whoisLePhuc/robot_charge_controller/simulation/README.md

# Simulation

This directory is reserved for SPICE testbenches, component models, simulation parameters, and analyzed results.

Every simulation must record model source and version, schematic revision, boundary conditions, sweeps or corners, limitations, and measurable acceptance criteria.
