whoisLePhuc/robot_charge_controller/tools/README.md

# Tools

Repository validation, export, and automation utilities belong here.

## Available Tool

- check_repository.py validates the baseline directory structure, Markdown encoding, documented path case, and local Markdown links.

KiCad source modifications must not be implemented with general-purpose text scripts; use the approved Konnect workflow.
