whoisLePhuc/robot_charge_controller/docs/03-design/README.md

# Detailed Design

This directory contains detailed circuit, component-selection, PCB-layout, and embedded-design documentation.

## Contents

- [`guides/`](guides/README.md): project layout, routing, EMI, and netclass guidance imported from the engineering workspace.

Guides provide design rationale and constraints; they do not replace schematic/PCB review, calculations, simulation, or verification evidence for a particular revision.
