whoisLePhuc/robot_charge_controller/hardware/templates/README.md

# Hardware Templates

Reusable, reviewed KiCad templates may be stored here.

The directory is currently a scaffold. A template must document its intended use, assumptions, library dependencies, KiCad version, and verification status.
