whoisLePhuc/robot_charge_controller/docs/04-calculations/README.md

# Calculations

This directory contains auditable engineering calculations associated with specific hardware revisions.

## Current Artifact

- [`INA241A2IDDFR_Output_Calculation.pdf`](INA241A2IDDFR_Output_Calculation.pdf): imported from the workspace calculation directory without transformation on 2026-08-25.

The imported PDF is supporting evidence only. Its input values, component identity, tolerances, temperature assumptions, schematic revision, and acceptance criteria must be reviewed before its results are used for a design or release decision.
