whoisLePhuc/robot_charge_controller/docs/05-reviews/README.md

# Reviews

This directory contains schematic, PCB, safety, EMC, thermal, reliability, manufacturability, and integration review findings.

Each review must identify the exact artifact revision, scope, tool versions, evidence, severity, disposition, owner, and open verification action. Review completion is not release authorization.
