whoisLePhuc/robot_charge_controller/firmware/src/README.md

# Firmware Source

Application entry points, state machines, hardware integration, and orchestration code belong here.

The source tree is currently a scaffold. Relay control must default to a defined safe state and must not be implemented before hardware and system requirements are recorded.
