whoisLePhuc/robot_charge_controller/docs/04-calculations/INA241A2IDDFR_Output_Calculation.pdf

## Tính toán tín hiệu đầu ra INA241A2IDDFR

## 1. Thông số thiết kế

Thông số | Ký hiệu | Giá trị
IC đo dòng | — | INA241A2IDDFR
Hệ số khuếch đại | G | 20 V /V
Điện trở shunt R17 | RS | 1, 8 mΩ
Nguồn cấp INA241 | VS | 3, 3 V
Điện áp tại REF1 | VREF1 | 3, 3 V
Điện áp tại REF2 | VREF2 | 0 V
Độ phân giải ADC giả định | — | 12 bit
Giá trị ADC lớn nhất | ADCFS | 4095

## 2. Điện áp tham chiếu đầu ra

Điện áp tham chiếu tương đương tại đầu ra được tính bằng:

VREF =

VREF1 + VREF2

2

Thay số:

VREF =

3, 3 + 0

2

= 1, 65 V

Do đó, khi dòng qua R17 bằng 0 A:

## 3. Điện áp vi sai trên điện trở shunt

Điện áp trên R17 được tính theo định luật Ohm:

VSHUNT = VIN+ − VIN− = I × RS

Với:

RS = 1, 8 mΩ = 0, 0018 Ω

VOUT (0 A) = 1, 65 V

Suy ra:

VSHUNT = 0, 0018I

Trong đó I được tính bằng ampere và VSHUNT được tính bằng volt.

Ví dụ tại dòng 20 A:

VSHUNT = 20 × 0, 0018 = 0, 036 V = 36 mV

## 4. Công thức điện áp đầu ra INA241A2

Điện áp đầu ra lý tưởng của INA241 được xác định bởi:

VOUT = VREF + G(VIN+ − VIN−)

Thay VIN+ − VIN− = I × RS:

VOUT = VREF + G × I × RS

Thay các giá trị của thiết kế:

VOUT = 1, 65 + 20 × I × 0, 0018

Suy ra công thức rút gọn:

Trong đó:

## 5. Quy ước chiều dòng điện

Nếu kết nối:

Thì:

Trạng thái | Quan hệ đầu ra
Dòng từ nguồn sang tải | VOUT > 1, 65 V
Không có dòng | VOUT ≈ 1, 65 V
Dòng từ tải về nguồn | VOUT < 1, 65 V

VOUT = 1, 65 + 0, 036I

I tính bằng ampere.
VOUT tính bằng volt.
Độ nhạy của mạch đo là 36 mV /A.

IN+ ở phía nguồn.
IN− ở phía tải.

Nếu đảo IN+ và IN− , dấu của thành phần dòng trong công thức cũng bị đảo.

## 6. Bảng điện áp đầu ra theo dòng điện

Dòng I | Điện áp trên R17 VSHUNT | Thành phần khuếch đại G × VSHUNT | Điện áp đầu ra VOUT
−31, 4 A | −56, 52 mV | −1, 1304 V | 0, 5196 V
−27, 8 A | −50, 04 mV | −1, 0008 V | 0, 6492 V
−20 A | −36 mV | −0, 72 V | 0, 93 V
−10 A | −18 mV | −0, 36 V | 1, 29 V
0 A | 0 mV | 0 V | 1, 65 V
+10 A | +18 mV | +0, 36 V | 2, 01 V
+20 A | +36 mV | +0, 72 V | 2, 37 V
+27, 8 A | +50, 04 mV | +1, 0008 V | 2, 6508 V
+31, 4 A | +56, 52 mV | +1, 1304 V | 2, 7804 V

Tại dòng hoạt động liên tục 20 A:

Tại ngưỡng giới hạn dòng danh định của LT4356, xấp xỉ 27,8 A:

Tại ngưỡng dòng cao nhất dự kiến, xấp xỉ 31,4 A:

Các giá trị này đều nhỏ hơn 3,3 V nên phù hợp với đầu vào ADC 3,3 V của ESP32 trong điều kiện thiết kế đang xét.

## 7. Tính dòng điện từ điện áp đầu ra

Từ công thức:

VOUT = 1, 65 + 0, 036I

Suy ra:

Ví dụ, khi ADC đo được VOUT = 2, 37 V :

I =

2, 37 − 1, 65

0, 036

= 20 A

VOUT (20 A) = 2, 37 V

VOUT (27, 8 A) ≈ 2, 651 V

VOUT (31, 4 A) ≈ 2, 780 V

I =

VOUT − 1, 65

0, 036

Khi ADC đo được VOUT = 0, 93 V :

I =

0, 93 − 1, 65

0, 036

= −20 A

## 8. Quy đổi sang ADC 12 bit

Với ADC 12 bit và điện áp toàn thang lý tưởng bằng 3,3 V:

ADC =

VOUT

3, 3

× 4095

Ngược lại:

VOUT =

ADC

4095

× 3, 3

Thay vào công thức tính dòng:

Có thể rút gọn thành:

Theo mô hình lý tưởng, độ phân giải dòng điện trên mỗi LSB là:

ΔILSB =

3, 3/4095

0, 036

≈ 0, 02238 A

## Bảng giá trị ADC lý tưởng

Dòng | VOUT | Giá trị ADC lý tưởng
−31, 4 A | 0, 520 V | khoảng 645
−27, 8 A | 0, 649 V | khoảng 805
−20 A | 0, 930 V | khoảng 1154
−10 A | 1, 290 V | khoảng 1600
0 A | 1, 650 V | khoảng 2048
+10 A | 2, 010 V | khoảng 2494
+20 A | 2, 370 V | khoảng 2941
+27, 8 A | 2, 651 V | khoảng 3289
+31, 4 A | 2, 780 V | khoảng 3450

I =

(
ADC

4095

× 3, 3) − 1, 65

0, 036

I ≈ 0, 02238(ADC − 2047, 5)

ΔILSB ≈ 22, 4 mA/LSB

Các giá trị ADC trong bảng là giá trị lý tưởng. ADC của ESP32 có sai số offset, sai số gain và độ phi tuyến; do đó cần hiệu chuẩn trên phần cứng thực tế.

## 9. Dải dòng tuyến tính gần đúng

Đầu ra INA241 không thể đạt hoàn toàn tới 0 V hoặc 3,3 V. Để ước lượng bảo thủ, giả sử vùng đầu ra sử dụng được là:

0, 02 V ≲ VOUT ≲ 3, 10 V

## Giới hạn dòng âm

IMIN =

0, 02 − 1, 65

0, 036

≈ −45, 3 A

## Giới hạn dòng dương

IMAX =

3, 10 − 1, 65

0, 036

≈ 40, 3 A

Suy ra dải dòng tuyến tính ước lượng:

Đây chỉ là ước lượng thiết kế. Giới hạn đầu ra chính xác phải được đối chiếu với điều kiện tải đầu ra, nguồn cấp, nhiệt độ và các thông số swing-to-rail trong datasheet.

Toàn bộ vùng dòng cần đo từ −20 A đến khoảng +31, 4 A vẫn nằm trong dải đầu ra dự kiến.

## 10. Sai số cần tính đến

Kết quả tính toán phía trên là giá trị lý tưởng. Sai số đo thực tế còn phụ thuộc vào:

Để giảm sai số:

−45, 3 A ≲ I ≲ +40, 3 A

Sai số và TCR của R17.
Điện áp offset đầu vào của INA241A2. Sai số hệ số khuếch đại của INA241A2.
Sai số điện áp tạo bởi REF1 và REF2 .
Nhiễu trên nguồn 3,3 V.
Sai số, độ phi tuyến và suy hao do mạch RC ở ADC ESP32. Điện trở đường mạch và chất lượng kết nối Kelvin tại R17. Nhiệt độ của shunt, INA241 và PCB.

Lấy IN+ và IN− trực tiếp từ hai điểm Kelvin của R17. Đặt tụ bypass 100 nF sát chân nguồn INA241.

## 11. Tài liệu tham khảo

Đặt bộ lọc RC giữa OUT và ADC, ví dụ 1 kΩ nối tiếp và 10 nF xuống GND.
Lấy nhiều mẫu ADC và lọc trung bình trong firmware.
Hiệu chuẩn zero-current sau khi hệ thống ổn định nhiệt.
Nếu có thể, dùng điện áp tham chiếu ADC đã hiệu chuẩn thay vì mặc định chính xác 3,3 V.

Texas Instruments — INA241A datasheet (https://www.ti.com/lit/ds/symlink/ina241a.pdf) Texas Instruments — INA241 product page (https://www.ti.com/product/INA241A)
