whoisLePhuc/robot_charge_controller/docs/README.md

# Documentation

Project documentation is organized by lifecycle stage:

| Directory | Purpose |
|---|---|
| [01-requirements/](01-requirements/README.md) | Controlled system and interface requirements |
| [02-architecture/](02-architecture/README.md) | Architecture options, boundaries, and trade-offs |
| [03-design/](03-design/README.md) | Detailed design records and implementation guides |
| [04-calculations/](04-calculations/README.md) | Auditable engineering calculations |
| [05-reviews/](05-reviews/README.md) | Review findings and dispositions |
| [06-verification/](06-verification/README.md) | Verification plans, results, and traceability |
| [decisions/](decisions/README.md) | Architecture decision records |
| [workflow.md](workflow.md) | Repository and development workflow |

Every consequential record should identify the applicable hardware variant and exact revision. Do not treat a generic guide or an unversioned workspace artifact as verification evidence for a release.
