whoisLePhuc/robot_charge_controller/hardware/Split_Board_Design/Consolidated/Control_board/00-two-layers.png

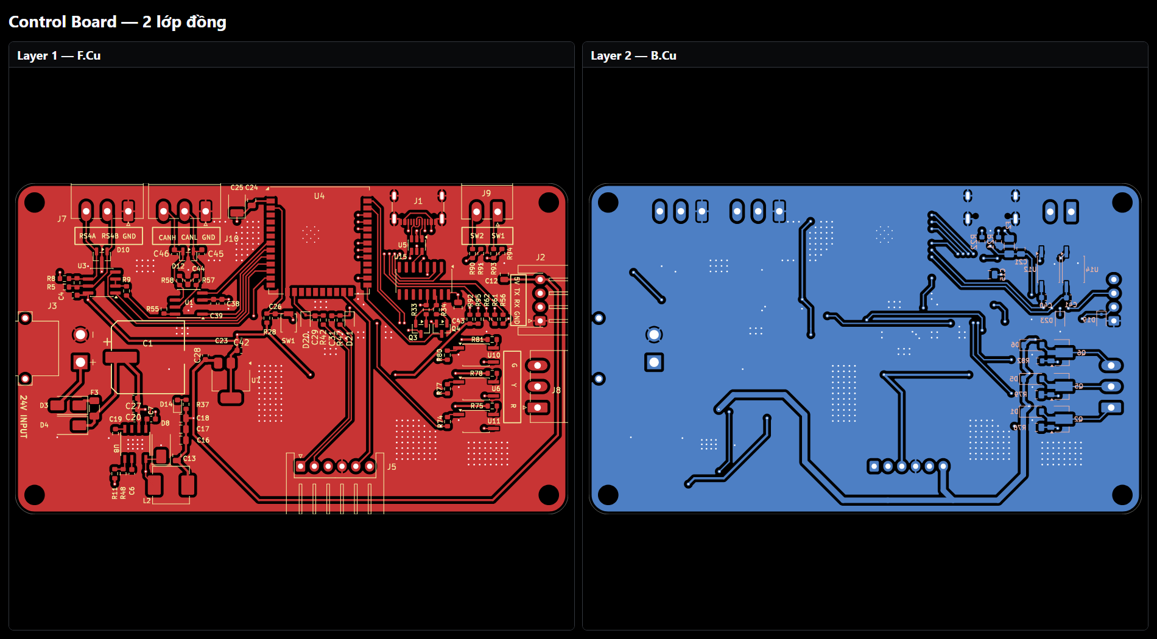
hardware/Split_Board_Design/Consolidated/Control_board/00-two-layers.png
