whoisLePhuc/robot_charge_controller/hardware/Split_Board_Design/Consolidated/Control_board/01-F_Cu.png

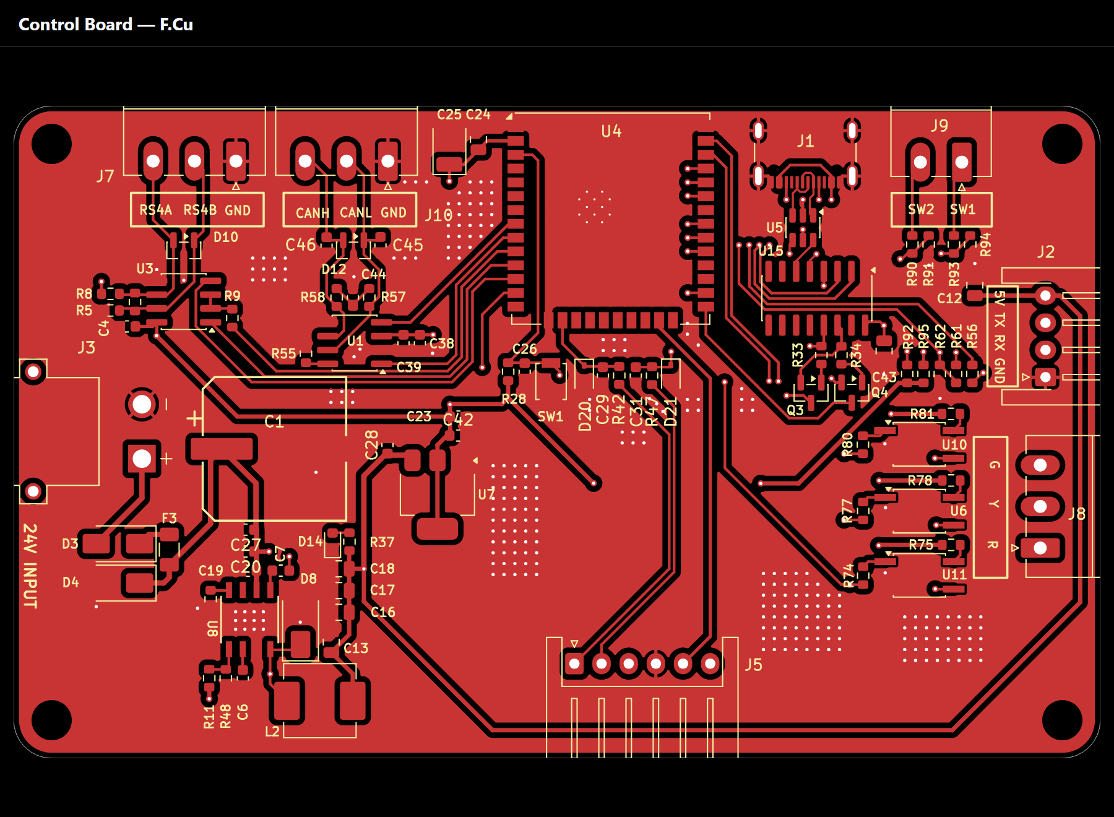
hardware/Split_Board_Design/Consolidated/Control_board/01-F_Cu.png
