whoisLePhuc/robot_charge_controller/hardware/Split_Board_Design/Consolidated/Control_board/02-B_Cu.png

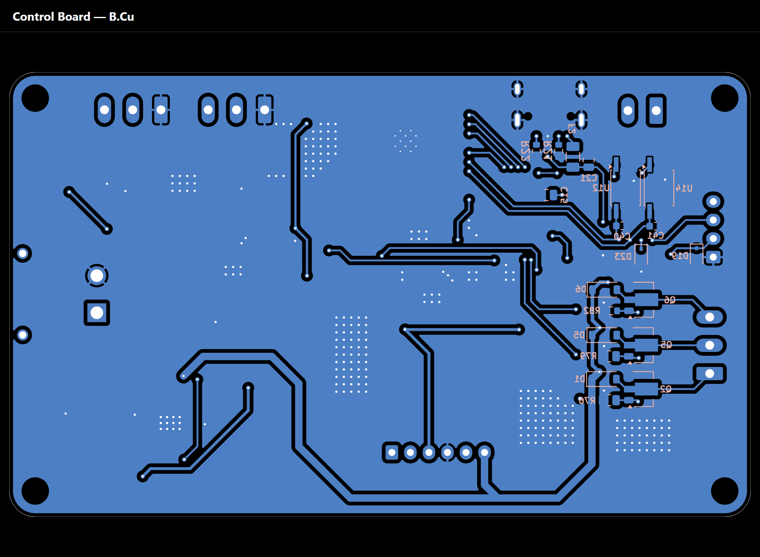
hardware/Split_Board_Design/Consolidated/Control_board/02-B_Cu.png
