whoisLePhuc/robot_charge_controller/hardware/Split_Board_Design/Consolidated/Control_board/03-3D-top.png

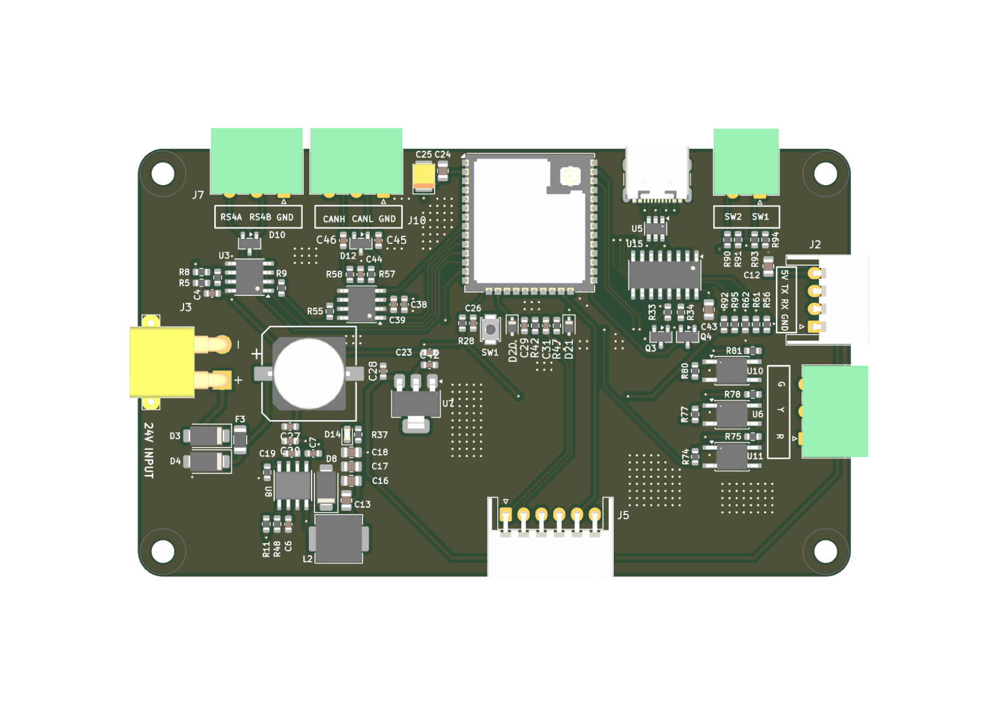
hardware/Split_Board_Design/Consolidated/Control_board/03-3D-top.png
