whoisLePhuc/robot_charge_controller/hardware/Split_Board_Design/Consolidated/Control_board/04-3D-bottom.png

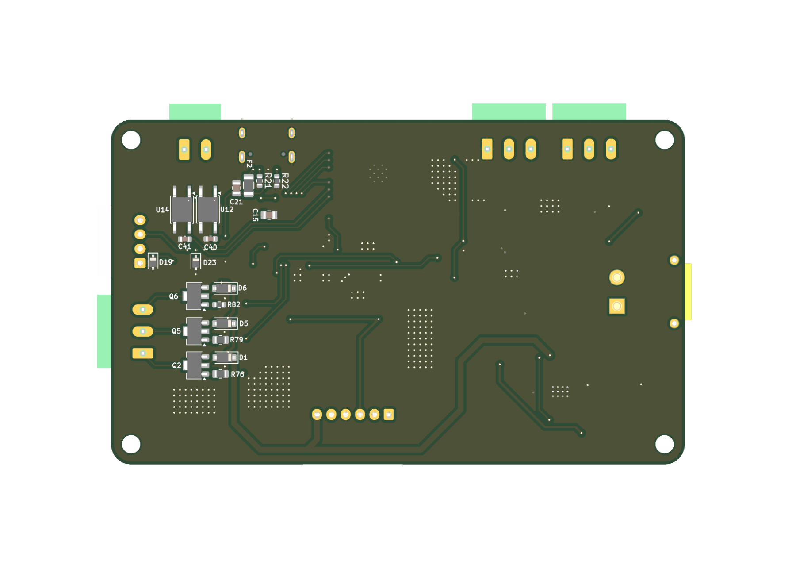
hardware/Split_Board_Design/Consolidated/Control_board/04-3D-bottom.png
