whoisLePhuc/robot_charge_controller/hardware/Split_Board_Design/Consolidated/Control_board/05-3D-isometric.png

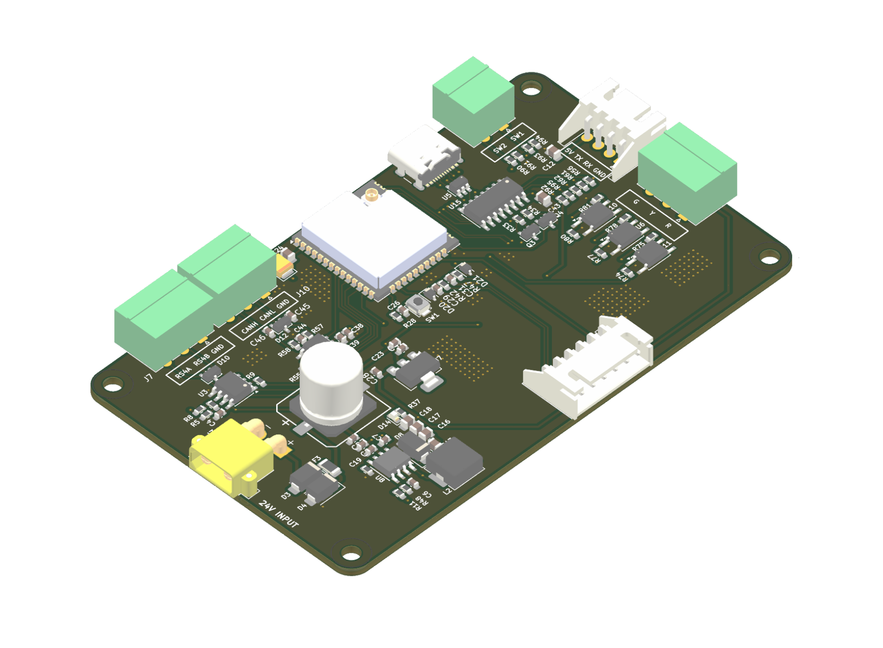
hardware/Split_Board_Design/Consolidated/Control_board/05-3D-isometric.png
