whoisLePhuc/robot_charge_controller/hardware/Split_Board_Design/Consolidated/Control_board/06-3D-isometric-opposite.png

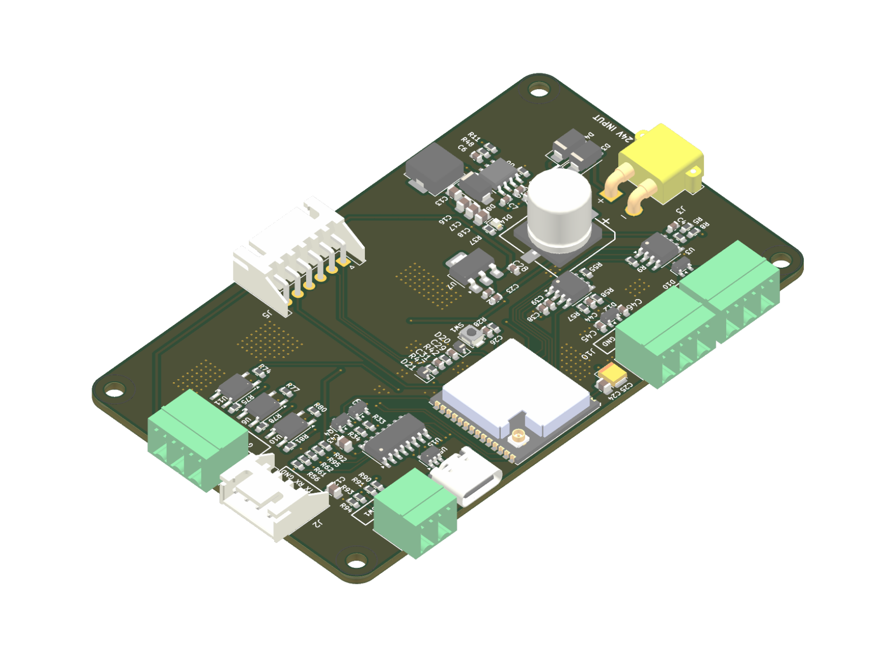
hardware/Split_Board_Design/Consolidated/Control_board/06-3D-isometric-opposite.png
