whoisLePhuc/robot_charge_controller/hardware/Split_Board_Design/Consolidated/Relay_board/00-four-layers.png

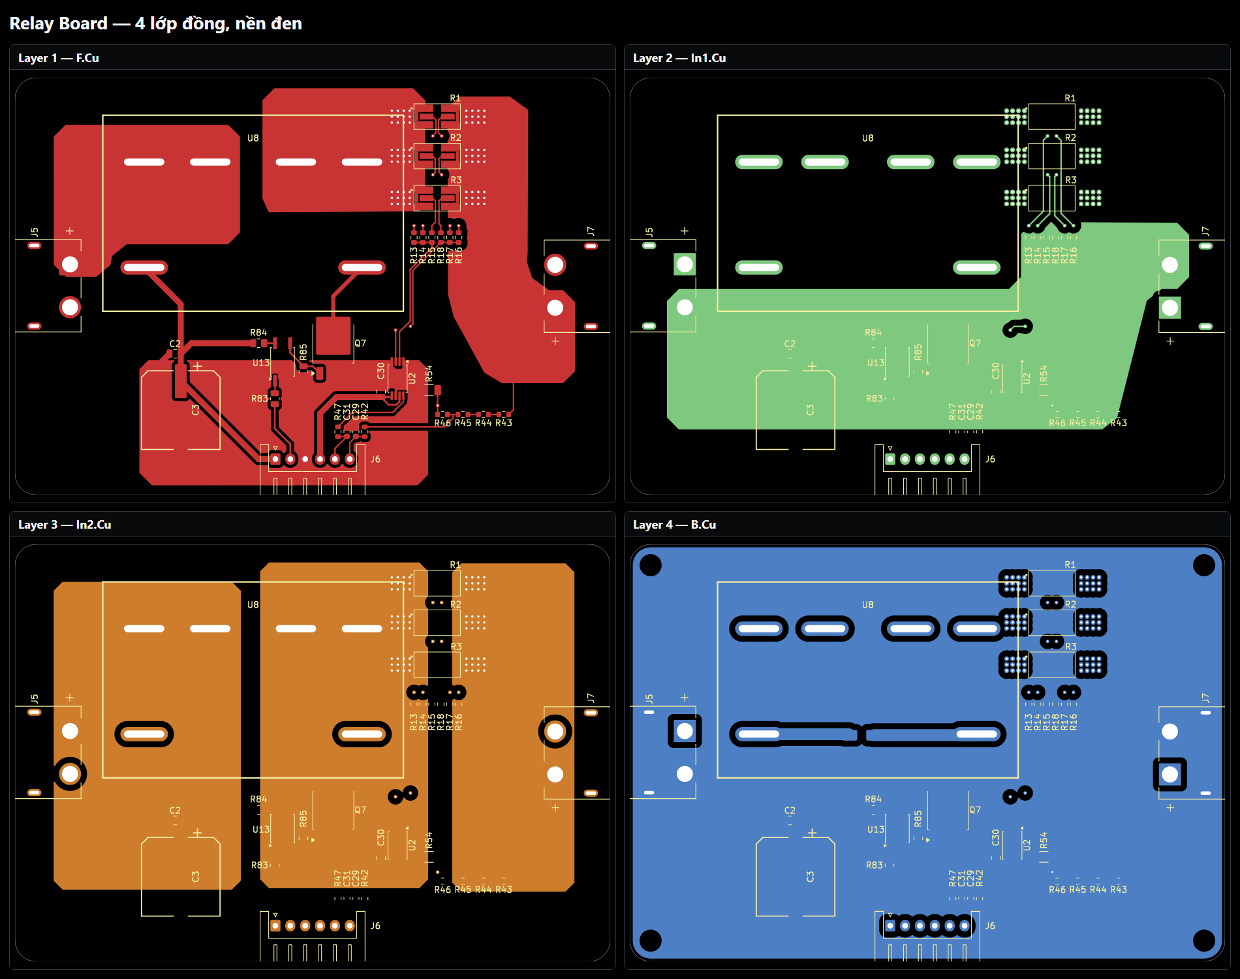
hardware/Split_Board_Design/Consolidated/Relay_board/00-four-layers.png
