whoisLePhuc/robot_charge_controller/hardware/Split_Board_Design/Consolidated/Relay_board/01-F_Cu.png

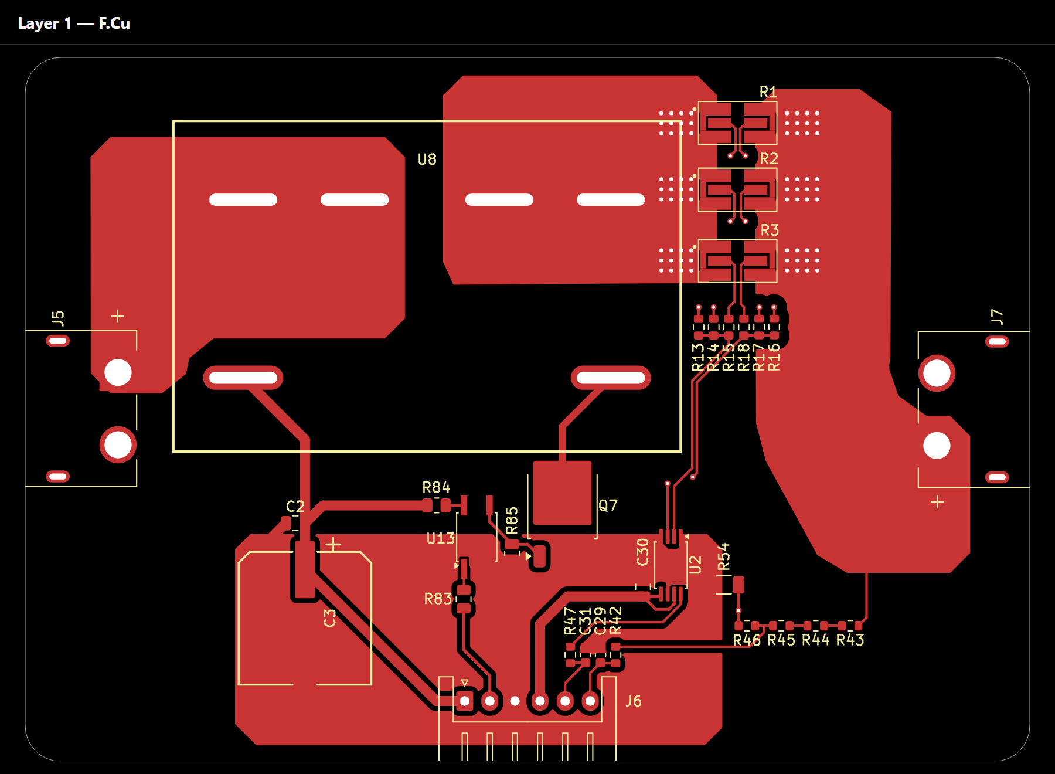
hardware/Split_Board_Design/Consolidated/Relay_board/01-F_Cu.png
