whoisLePhuc/robot_charge_controller/hardware/Split_Board_Design/Consolidated/Relay_board/02-In1_Cu.png

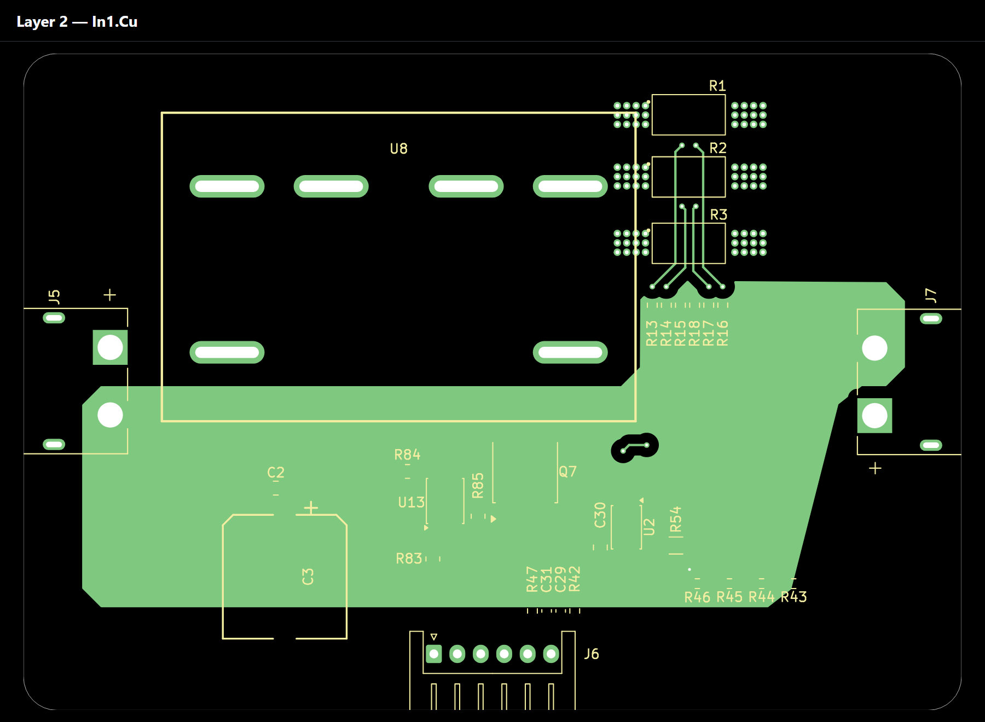
hardware/Split_Board_Design/Consolidated/Relay_board/02-In1_Cu.png
