whoisLePhuc/robot_charge_controller/hardware/Split_Board_Design/Consolidated/Relay_board/03-In2_Cu.png

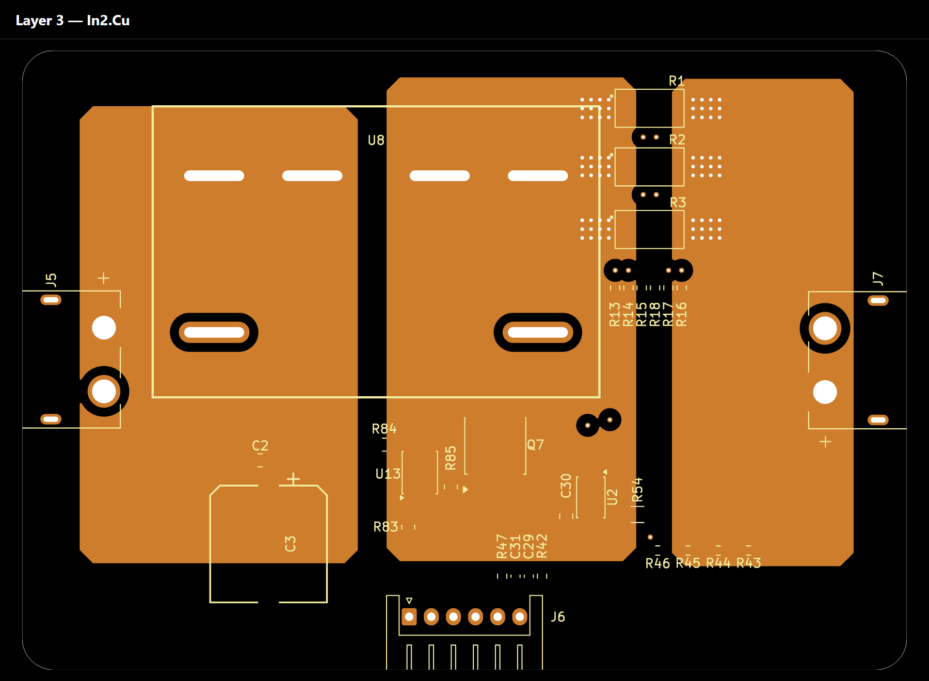
hardware/Split_Board_Design/Consolidated/Relay_board/03-In2_Cu.png
