whoisLePhuc/robot_charge_controller/hardware/Split_Board_Design/Consolidated/Relay_board/04-B_Cu.png

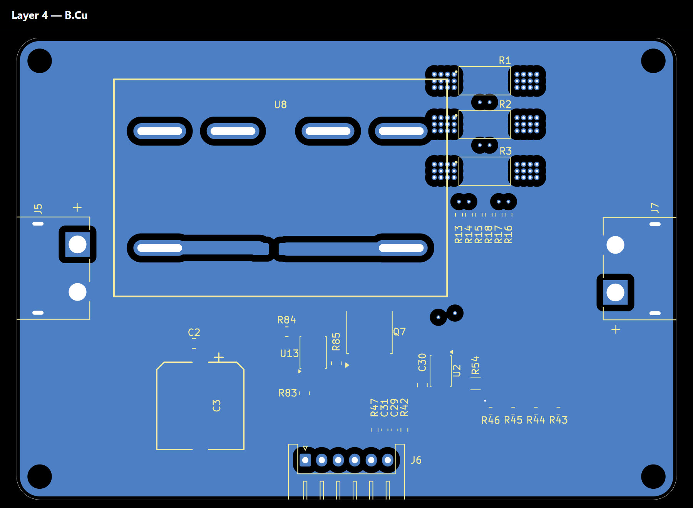
hardware/Split_Board_Design/Consolidated/Relay_board/04-B_Cu.png
