whoisLePhuc/robot_charge_controller/hardware/Split_Board_Design/Consolidated/Relay_board/05-3D-top.png

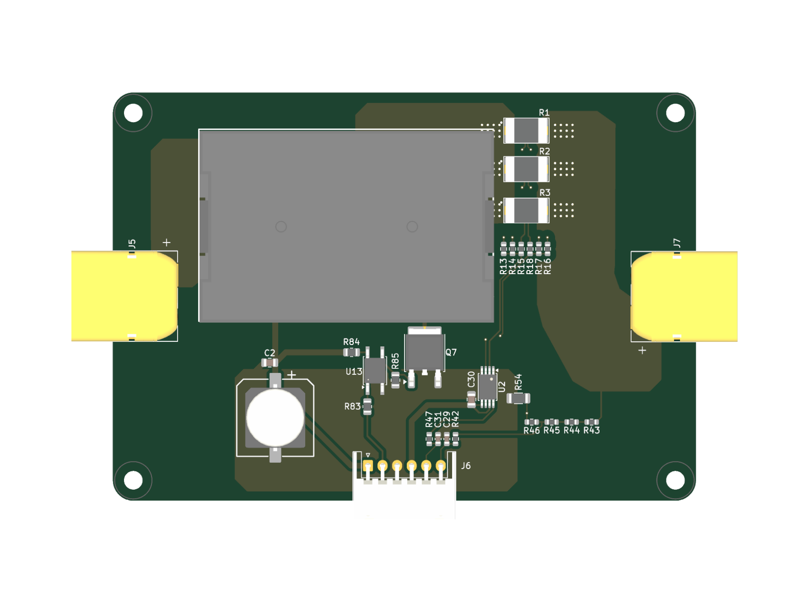
hardware/Split_Board_Design/Consolidated/Relay_board/05-3D-top.png
