whoisLePhuc/robot_charge_controller/hardware/Split_Board_Design/Consolidated/Relay_board/06-3D-bottom.png

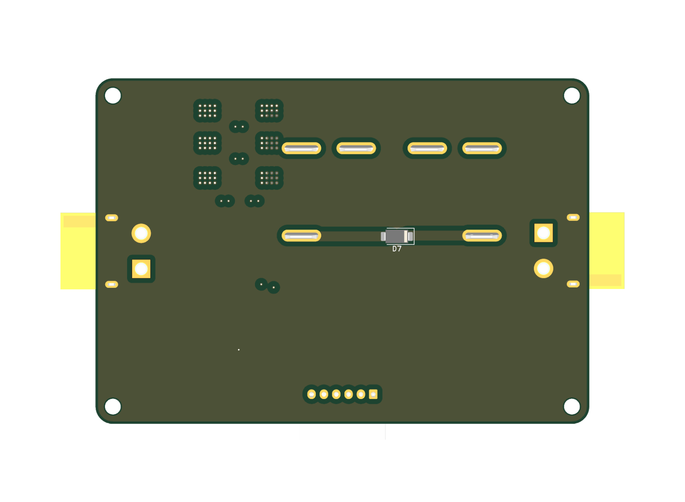
hardware/Split_Board_Design/Consolidated/Relay_board/06-3D-bottom.png
