whoisLePhuc/robot_charge_controller/hardware/Split_Board_Design/Consolidated/Relay_board/07-3D-isometric.png

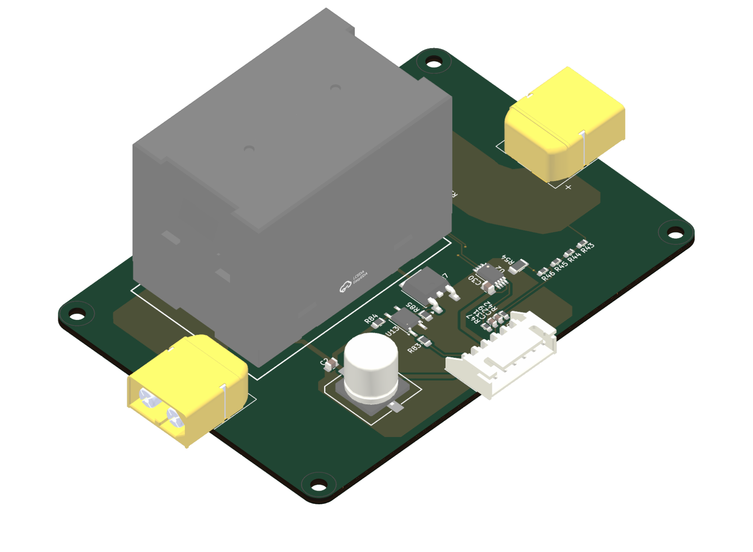
hardware/Split_Board_Design/Consolidated/Relay_board/07-3D-isometric.png
