whoisLePhuc/robot_charge_controller/hardware/Split_Board_Design/Consolidated/Relay_board/08-3D-isometric-opposite.png

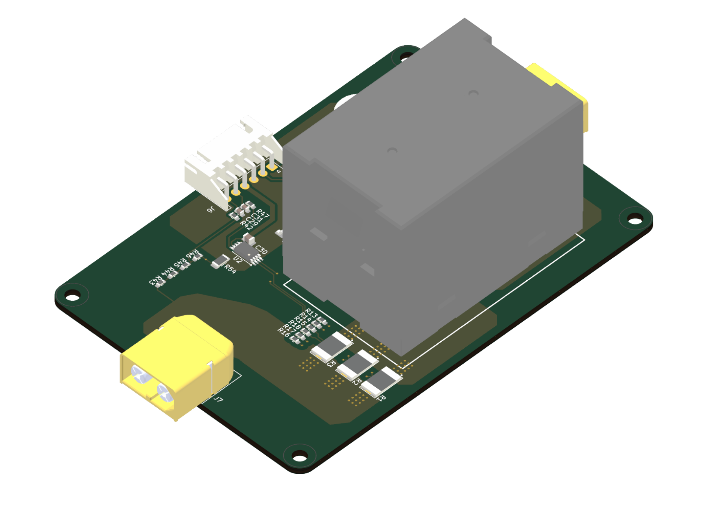
hardware/Split_Board_Design/Consolidated/Relay_board/08-3D-isometric-opposite.png
