whoisLePhuc/robot_charge_controller/components/README.md

# Components

This directory contains component-selection records, BOM source files, qualified alternatives, datasheet indexes, and supply-chain notes.

## Contents

- [`bom/`](bom/README.md): current BOM workbook candidates imported from the engineering workspace.

Orderable manufacturer part numbers, alternates, lifecycle status, and sourcing evidence must be reviewed before a manufacturing release.
