whoisLePhuc/robot_charge_controller/components/Bill of Materials-Control_Board_V1.0.xlsx

Comment | Manufacturer Part Number | Designator | LibRef | Quantity | Price/1PCS | Price/1Board | Component Link/URL
0R | AC1206FR-070RL | R54 | R_1206_3216Metric | 1 | 45 | 45 | https://linhkien.cxtvn.com/3667-dien-tro-0r-1206-1-100c.html
33pF-50V | C0805C330J5GACTU | C13 | C_0805_2012Metric | 1 | 200 | 200 | https://linhkien.cxtvn.com/1976-tu-khong-phan-cuc-0805.html
22nF-50V | CC0603KRX7R9BB223 | C6 | C_0603_1608Metric | 1 | 200 | 200 | https://linhkien.cxtvn.com/2513-tu-0603-khong-phan-cuc.html
100nF-50V | CC0805KRX7R9BB104 | C12,C15,C18,C24,C30,C43 | C_0805_2012Metric | 6 | 180 | 1080 | https://linhkien.cxtvn.com/1976-tu-khong-phan-cuc-0805.html
6.8uH | FXL0630-6R8-M | L2 | L_Changjiang_FXL0630 | 1 | 1925 | 1925 | https://linhkien.cxtvn.com/9904-cuon-cam-0630-cac-gia-tri.html
10uF-50V | CL21A106KAYNNNE | C21 | C_0805_2012Metric | 1 | 180 | 180 | https://linhkien.cxtvn.com/1976-tu-khong-phan-cuc-0805.html
10uF-25V | T491A106K010AT | C25 | CP_EIA-3528-12_Kemet-T | 1 | 3000 | 3000 | https://linhkien.cxtvn.com/4430-tu-tantalum-3528-cac-gia-tri.html
22uF-50V | C2012X5R1A226KT000N | C16,C17 | C_0805_2012Metric | 2 | 475 | 950 | https://linhkien.cxtvn.com/1976-tu-khong-phan-cuc-0805.html
100uF-50V | EEE-FK1H101P | C1 | CP_Elec_8x10.5 | 1 | 1300 | 1300 | https://linhkien.cxtvn.com/3033-tu-nhom-100uf-50v-8x105-5c.html
1kR | 0603WAF1001T5E | R47,R74,R77,R80 | R_0603_1608Metric | 4 | 36 | 144 | https://linhkien.cxtvn.com/1424-dien-tro-1k-0603-1-100c.html
3.3kR | 0603WAF3301T5E | R75,R78,R81,R90,R92,R93,R95 | R_0603_1608Metric | 7 | 36 | 252 | https://linhkien.cxtvn.com/2289-dien-tro-33k-0603-1-100c.html
4.7kR | 0603WAF4701T5E | R37 | R_0603_1608Metric | 1 | 36 | 36 | https://linhkien.cxtvn.com/2398-dien-tro-47k-0603-1-100c.html
5.1kR | 0603WAF5101T5E | R21,R22 | R_0603_1608Metric | 2 | 36 | 72 | https://linhkien.cxtvn.com/2291-dien-tro-51k-0603-1-100c.html
10kR | FRC0603F1002TS | R5,R8,R9,R28,R33,R34,R42,R55,R61,R82,R91,R94 | R_0603_1608Metric | 12 | 36 | 432 | https://linhkien.cxtvn.com/1422-dien-tro-10k-0603-1-100c.html
10kR | 0805W8F1002T5E | R76,R79 | R_0805_2012Metric | 2 | 36 | 72 | https://linhkien.cxtvn.com/1422-dien-tro-10k-0603-1-100c.html
12kR | 0603WAF1202T5E | R48 | R_0603_1608Metric | 1 | 36 | 36 | https://linhkien.cxtvn.com/4536-dien-tro-12k-0603-1-100c.html
15kR | 0603WAF1502T5E | R62 | R_0603_1608Metric | 1 | 36 | 36 | https://linhkien.cxtvn.com/4434-dien-tro-15k-0603-1-100c.html
18kR | 0603WAF1802T5E | R46 | R_0603_1608Metric | 1 | 36 | 36 | https://linhkien.cxtvn.com/7646-dien-tro-18k-0603-1-100c.html
47R | AC0603FR-0747RL | R56 | R_0603_1608Metric | 1 | 36 | 36 | https://linhkien.cxtvn.com/3447-dien-tro-120r-0603-1-100c.html
49.9R | RC0603FR-0749R9L | R10 | R_0603_1608Metric | 1 | 36 | 36 | https://linhkien.cxtvn.com/2395-dien-tro-499r-0603-1-100c.html
68kR | 0603WAF6802T5E | R11 | R_0603_1608Metric | 1 | 36 | 36 | https://linhkien.cxtvn.com/2304-dien-tro-68k-0603-1-100c.html
120R | AC0603FR-07120RL | R4,R57,R58 | R_0603_1608Metric | 3 | 36 | 108 | https://linhkien.cxtvn.com/3447-dien-tro-120r-0603-1-100c.html
150kR | 0603WAF1503T5E | R43,R44,R45 | R_0603_1608Metric | 3 | 36 | 108 | https://linhkien.cxtvn.com/9710-dien-tro-150k-0603-1-100c.html
100nF-50V | CC0603KRX7R9BB104 | C4,C7,C19,C23,C29,C38,C40,C41 | C_0603_1608Metric | 8 | 180 | 1440 | https://linhkien.cxtvn.com/1981-tu-0603-khong-phan-cuc.html
10nF-50V | GRM188R71H103KA01D | C31 | C_0603_1608Metric | 1 | 200 | 200 | https://linhkien.cxtvn.com/6736-0603b104k500nt-tu-100nf-50v-10-0603-20c.html
10uF-50V | GRM21BR61H106KE43L | C27,C28,C39 | C_0603_1608Metric | 3 | 230 | 690 | https://linhkien.cxtvn.com/2886-tu-106-10uf-0603-50v-10-20c.html
1uF-50V | CL10A105KB8NNNC | C20,C26,C42 | C_0603_1608Metric | 3 | 200 | 600 | https://linhkien.cxtvn.com/1982-tu-105-1uf-0603-50v-10-20c.html
2SD882 | 2SD882T-P | Q2,Q5,Q6 | SOT-89-3 | 3 | 600 | 1800 | https://linhkien.cxtvn.com/3565-d882-2sd882-npn-transistor-15a-40v-sot-89-10c.html
33pF-50V | GRM1885C1H330JA01D | C44,C45,C46 | C_0603_1608Metric | 3 | 200 | 600 | https://linhkien.cxtvn.com/3426-tu-330-33pf-0603-50v-20c.html
BC817 | BC817-40,215 | Q3,Q4 | SOT-23 | 2 | 650 | 1300 | https://linhkien.cxtvn.com/5979-bc817-40-transistor-npn-45v-05a-sot23-10c.html
CH340C | CH340C | U15 | SOIC-16_3.9x9.9mm_P1.27mm | 1 | 11000 | 11000 | https://linhkien.cxtvn.com/4690-ch340c-ic-transceiver-2mbps-usb20-sop-16.html
Conn_01x02 | 1803277 | J9 | PhoenixContact_MC_1,5_2-G-3.81_1x02_P3.81mm_Horizontal | 1 | 2000 | 2000 | https://linhkien.cxtvn.com/3486-cau-dau-15edg381-381mm-xanh-cong-mau-nhat.html
Conn_01x03 | 1803280 | J7,J8,J10 | PhoenixContact_MC_1,5_3-G-3.81_1x03_P3.81mm_Horizontal | 3 | 2900 | 8700 | https://linhkien.cxtvn.com/3486-cau-dau-15edg381-381mm-xanh-cong-mau-nhat.html
Conn_01x06 | S6B-XH-A(LF)(SN) | J5 | JST_XH_S6B-XH-A_1x06_P2.50mm_Horizontal | 1 | 280 | 280 | https://linhkien.cxtvn.com/3878-header-duc-xh254-6p-chan-cong-10c.html
Button | B3U-1000P | SW1 | SW_SPST_B3U-1000P | 1 | 3000 | 3000 | https://linhkien.cxtvn.com/10278-b3u-1000p-nut-nhan-smd-2p-3x25x16mm.html
ESD2CANFD24DBZR | ESD2CANFD24DBZR | D12 | SOT-23 | 1 | 4800 | 4800 | https://www.lcsc.com/product-detail/C20345391.html?s_z=n_q_ESD2CANFD24
ESP32-WROOM-32E | ESP32-WROOM-32E-N16 | U4 | ESP32-WROOM-32UE | 1 | 95000 | 95000 | https://linhkien.cxtvn.com/9356-esp32-wroom-32ue-n16-rf-txrx-module-wifi-ufl-smd.html
INA240A2PW | INA240A2PWR | U2 | TSSOP-8_4.4x3mm_P0.65mm | 1 | 88900 | 88900 | https://www.lcsc.com/product-detail/C1346461.html?s_z=n_q_INA240A2
LED_GREEN | XL-1608UGC-04 | D14 | LED_0603_1608Metric | 1 | 190 | 190 | https://linhkien.cxtvn.com/4216-led-0603-cac-mau.html
LTV-356T | LTV-356T-C | U6,U10,U11,U12,U14 | SO-4_4.4x3.6mm_P2.54mm | 5 | 1700 | 8500 | https://linhkien.cxtvn.com/5731-ltv-356t-c-optoisolator-375kv-trans-4-sop.html
LV14340DDAR | LV14340DDAR | U8 | SOIC8_DDA_TEX | 1 | 39000 | 39000 | https://banlinhkiendientu.vn/lv14340ddar-14340-ic-nguon-sop8/
MAX3485 | MAX3485ESA | U3 | SOIC-8_3.9x4.9mm_P1.27mm | 1 | 7000 | 7000 | https://linhkien.cxtvn.com/2485-max3485esa-ic-transceiver-half-11-8soic.html
FSMD100 | FSMD100-1206R | F3,F2 | Fuse_1206_3216Metric | 2 | 900 | 1800 | https://linhkien.cxtvn.com/4310-cau-chi-tu-phuc-hoi-pptc-smd1206.html
PESD5Z3.3 | PESD3V3U1UA,115 | D19,D20,D23 | D_SOD-323 | 3 | 200 | 600 | https://linhkien.cxtvn.com/7411-pesd5z33-tvs-diode-33vwm-18vc-sod523-10c.html
RS1M | RS1M | D1,D5,D6 | D_SOD-123 | 3 | 500 | 1500 | https://linhkien.cxtvn.com/9278-rs1m-fr107-f7-diode-xung-1a-1000v-sod123-10c.html
SM712 | SM712-02HTG | D10 | SOT-23 | 1 | 13000 | 13000 | https://linhkien.cxtvn.com/6062-sm712-02htg-tvs-diode-12v-31v-sot23-3.html
SMAJ36CA | SMAJ36CA | D4 | DO-214AC | 1 | 1000 | 1000 | https://linhkien.cxtvn.com/2361-smaj36ca-tvs-diode-36v-581v-smado214ac-5c.html
SS34 | B340A-13-F | D3,D8 | DO-214AC | 2 | 800 | 1600 | https://linhkien.cxtvn.com/1128-diode-ss34-sma-3a-40v-do-214ac.html
TCAN3414DR | TCAN3414DR | U1 | SOIC-8_3.9x4.9mm_P1.27mm | 1 | 47700 | 47700 | https://www.lcsc.com/product-image/C22396693.html?whichImg=0
TLV1117-33 | TLV1117LV33DCYR | U7 | SOT-223-3_TabPin2 | 1 | 7000 | 7000 | https://linhkien.cxtvn.com/10200-tlv1117lv33dcyr-ic-reg-lin-33v-1a-sot223-4.html/page-6
UART_CONN | S4B-XH-A-1(LF)(SN) | J2 | JST_XH_S4B-XH-A-1_1x04_P2.50mm_Horizontal | 1 | 190 | 190 | https://linhkien.cxtvn.com/3053-header-duc-xh254-chan-cong.html
USB2.0_16P | USB4105-GF-A | J1 | USB_C_Receptacle_GCT_USB4105-xx-A_16P_TopMnt_Horizontal | 1 | 1600 | 1600 | https://linhkien.cxtvn.com/6914-cong-type-c-cai-16p-usb-31-v25c.html
USBLC6-2SC6 | USBLC6-2SC6 | U5 | SOT-23-6 | 1 | 2800 | 2800 | https://linhkien.cxtvn.com/6071-usblc6-2sc6-tvs-diode-525v-17v-sot23-62c.html
XT30PW-M | XT30PW-M30.G.Y | J3 | AMASS_XT30PW-M | 1 | 7000 | 7000 | https://www.lcsc.com/product-detail/C53373776.html?s_z=n_q_x_XT30PW-M
Stencil |  |  |  | 1 | 178000 | 178000 | Buy only once
PCB (Estimate) |  |  |  | 1 | 50000 | 50000
TOTAL |  |  |  |  |  | 599110 | The price above does not include shipping fees and customs fees, if any.
