whoisLePhuc/robot_charge_controller/components/Bill of Materials-Relay_Board_V1.0.xlsx

Comment | Manufacturer Part Number | Designator | LibRef | Quantity | Price/1PCS | Price/1Board | Component Link/URL
1R | RC0603FR-071RL | R13, R14, R15, R16, R17 ,R18 | R_0603_1608Metric | 6 | 36 | 216 | https://linhkien.cxtvn.com/5753-dien-tro-1r-0603-1-100c.html
1kR | RC0805DR-071KL | R83 | R_0805_2012Metric | 1 | 280 | 280 | https://linhkien.cxtvn.com/9913-dien-tro-1k-0805-05-18w-20c.html
2mR | FPM253WFR002TML | R1, R2, R3 | R_Shunt_FOJAN_2512L_4Terminal_Kelvin_C | 3 | 1600 | 4800 | https://www.lcsc.com/product-detail/C7420017.html?s_z=n_q_C7420017&globalKeyword=C7420017
3.3kR | RC0805FR-073K3L | R84 | R_0805_2012Metric | 1 | 46 | 46 | https://linhkien.cxtvn.com/4177-dien-tro-33k-0805-1-100c.html
10kR | RT0805BRD0710KL | R85 | R_0805_2012Metric | 1 | 450 | 450 | https://linhkien.cxtvn.com/8792-dien-tro-10k-0805-01-10c.html
100nF-50V | CC0805KRX7R9BB104 | C2 | C_0805_2012Metric | 1 | 180 | 180 | https://linhkien.cxtvn.com/1976-tu-104-100nf-0805-50v-10-50c.html
680uf-35v | 35TLV680M12.5X13.5 | C3 | CP_Elec_12.5x13.5_Generic_H13 | 1 | 4600 | 4600 | https://linhkien.cxtvn.com/3037-tu-nhom-680uf-35v-125x135mm.html
Conn_01x06 | S6B-XH-A(LF)(SN) | J6 | JST_XH_S6B-XH-A_1x06_P2.50mm_Horizontal | 1 | 560 | 560 | https://linhkien.cxtvn.com/3878-header-duc-xh254-6p-chan-cong-10c.html
HF116F-80/24-1HTF | HF116F-80/24-1HTF | U8 | RELAY-TH_HF116F-80-XX-1HTF | 1 | 530000 | 530000 | https://www.lcsc.com/product-detail/C5322130.html?s_z=n_q_HF116F-80%252F24-1HTF
LTV-356T | LTV-356T-C | U13 | SO-4_4.4x3.6mm_P2.54mm | 1 | 1700 | 1700 | https://linhkien.cxtvn.com/5731-ltv-356t-c-optoisolator-375kv-trans-4-sop.html
MJD41CT4G | MJD41CT4G | Q7 | TO-252-2 | 1 | 4000 | 4000 | https://linhkien.cxtvn.com/2737-mjd41c-tip41c-npn-transistor-100v-6a-to-252-2.html
US1M | US1M-13-F | D7 | DO-214AC | 1 | 370 | 370 | https://linhkien.cxtvn.com/9736-her107-us1m-diode-1a-1000v-smado-214ac-10c.html
XT60PW-M | XT60PW-M | J5,J7 | AMASS_XT60PW-M | 2 | 8000 | 16000 | https://dientutuyetnga.com/products/xt60pw-m-dau-jack-noi-dien-xt60-duc
Stencil |  |  |  | 1 | 178000 | 178000 | Buy only once
PCB (ESTIMATED) |  |  |  | 1 | 50000 | 50000
TOTAL |  |  |  |  |  | 791202 | The price above does not include shipping fees and customs fees, if any.
PCB (ESTIMATED) |  |  |  | 1 | 50000
Total |  |  |  |  |  |  | The price above does not include shipping fees and customs fees, if any.
 |  |  |  |  |  | 50000
 |  |  |  |  |  | 1632404
