whoisLePhuc/robot_charge_controller/manufacturing/README.md

# Manufacturing

This directory is reserved for fabrication notes, assembly instructions, controlled release packages, and manufacturing verification records.

Generated Gerbers, drill files, BOM, and placement data must be tied to an exact source revision and independently reviewed before release. No production package is currently authorized.
