whoisLePhuc/robot_charge_controller/docs/03-design/guides/README.md

# Design Guides

| Guide | Scope |
|---|---|
| [`relay_60V_20A_EMI_layout_component_guideline.md`](relay_60V_20A_EMI_layout_component_guideline.md) | Relay-path component placement and EMI/layout guidance |
| [`robot-hv-charge-controller-2-layer-layout-routing-guide.md`](robot-hv-charge-controller-2-layer-layout-routing-guide.md) | Two-layer PCB layout and routing guidance |
| [`robot-hv-charge-controller-netclass-guide.md`](robot-hv-charge-controller-netclass-guide.md) | Project netclass intent and routing constraints |

These files were imported from the workspace documentation directory on 2026-08-25. They must be reconciled with the active KiCad rules and the applicable board revision before being treated as controlled requirements.
