whoisLePhuc/robot_charge_controller/test/README.md

# Hardware Test

This directory is reserved for bring-up procedures, fixtures, measurements, oscilloscope captures, raw data, and analyzed verification reports.

Tests involving the 60 VDC/20 A path require a reviewed procedure, current-limited setup, suitable protection, qualified supervision, and clearly defined stop conditions.
