whoisLePhuc/robot_charge_controller/docs/06-verification/README.md

# Verification

This directory contains verification plans, requirement-to-test traceability, test procedures, raw results, analyzed results, and residual open actions.

Every result must identify the hardware, firmware, setup, instrumentation, environment, date, and acceptance criterion. A successful tool run is not automatically a verified requirement.
