whoisLePhuc/robot_charge_controller/hardware/Split_Board_Design/Consolidated/Control_board/control-board.pdf

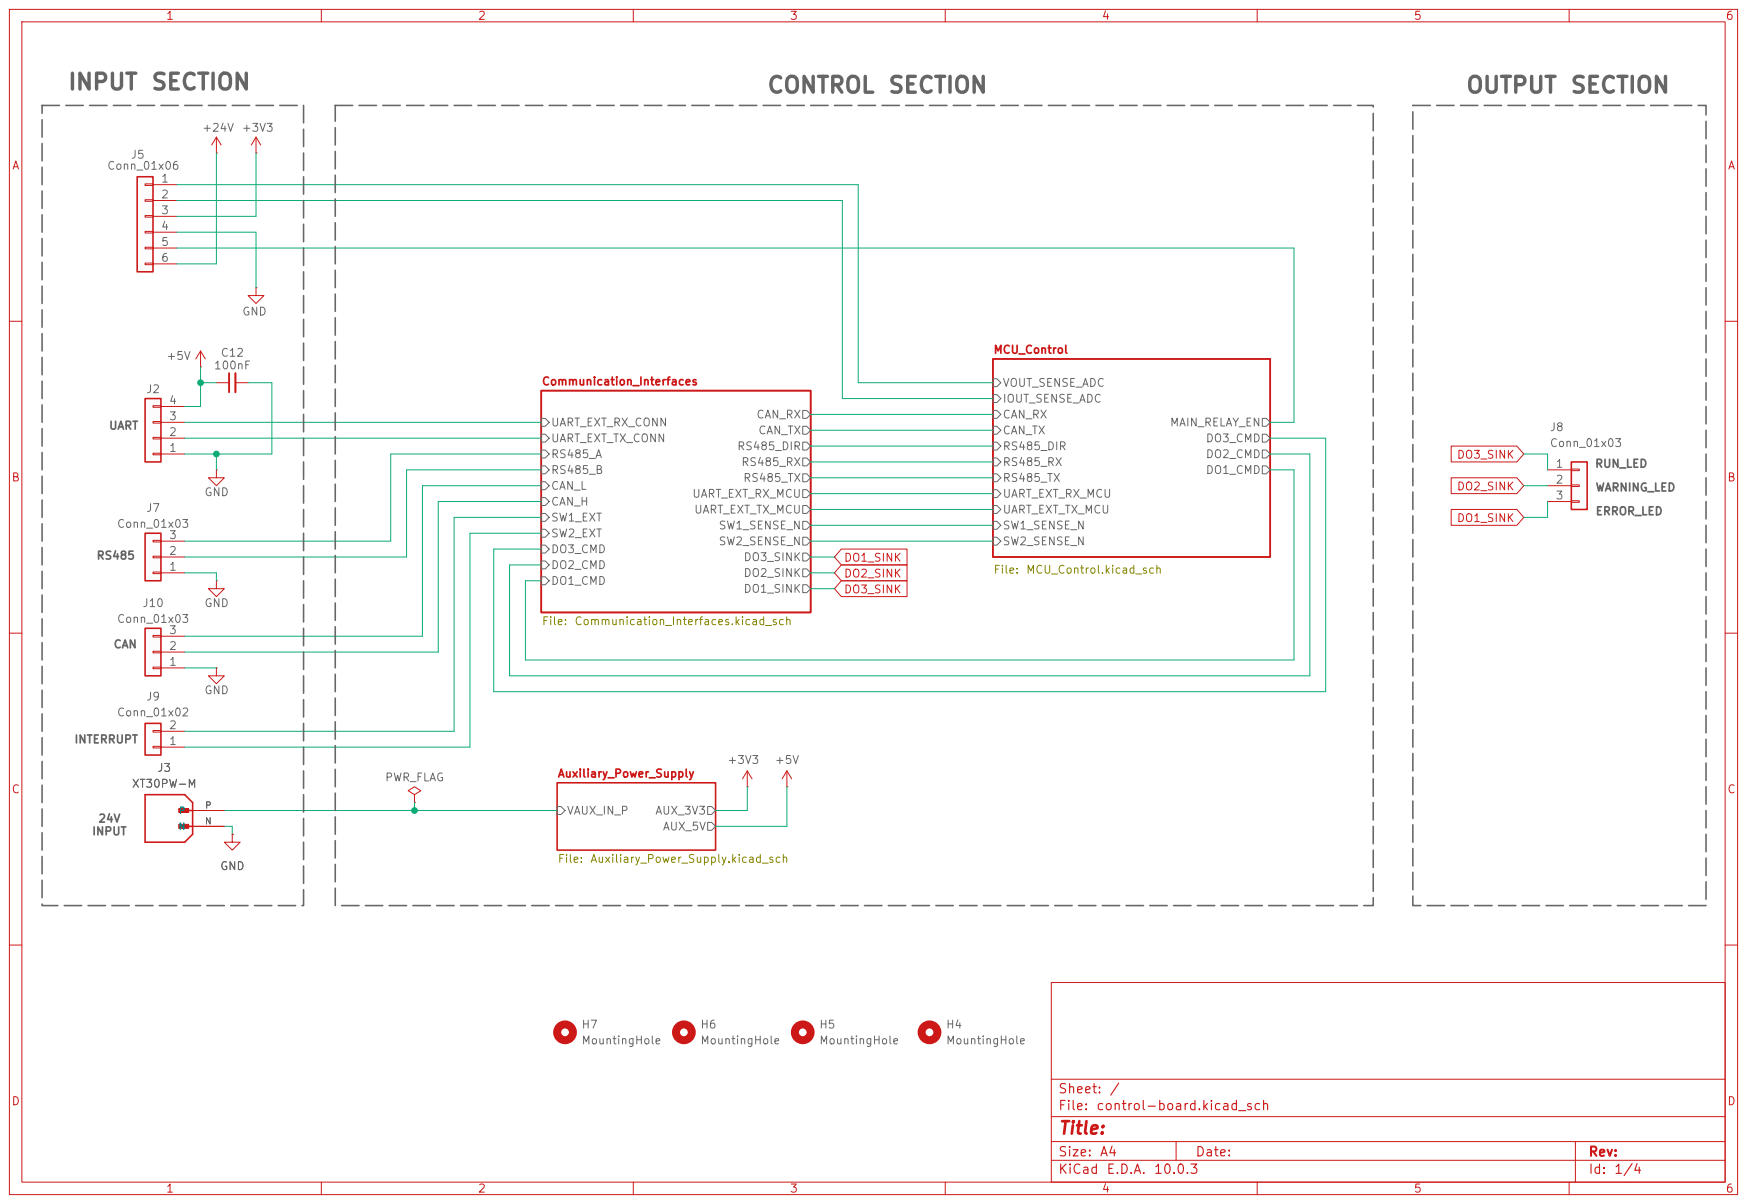
[picture p17: page 1]

Size: A4 | Rev:
KiCad E.D.A. 10.0.3 | Id: 1/4

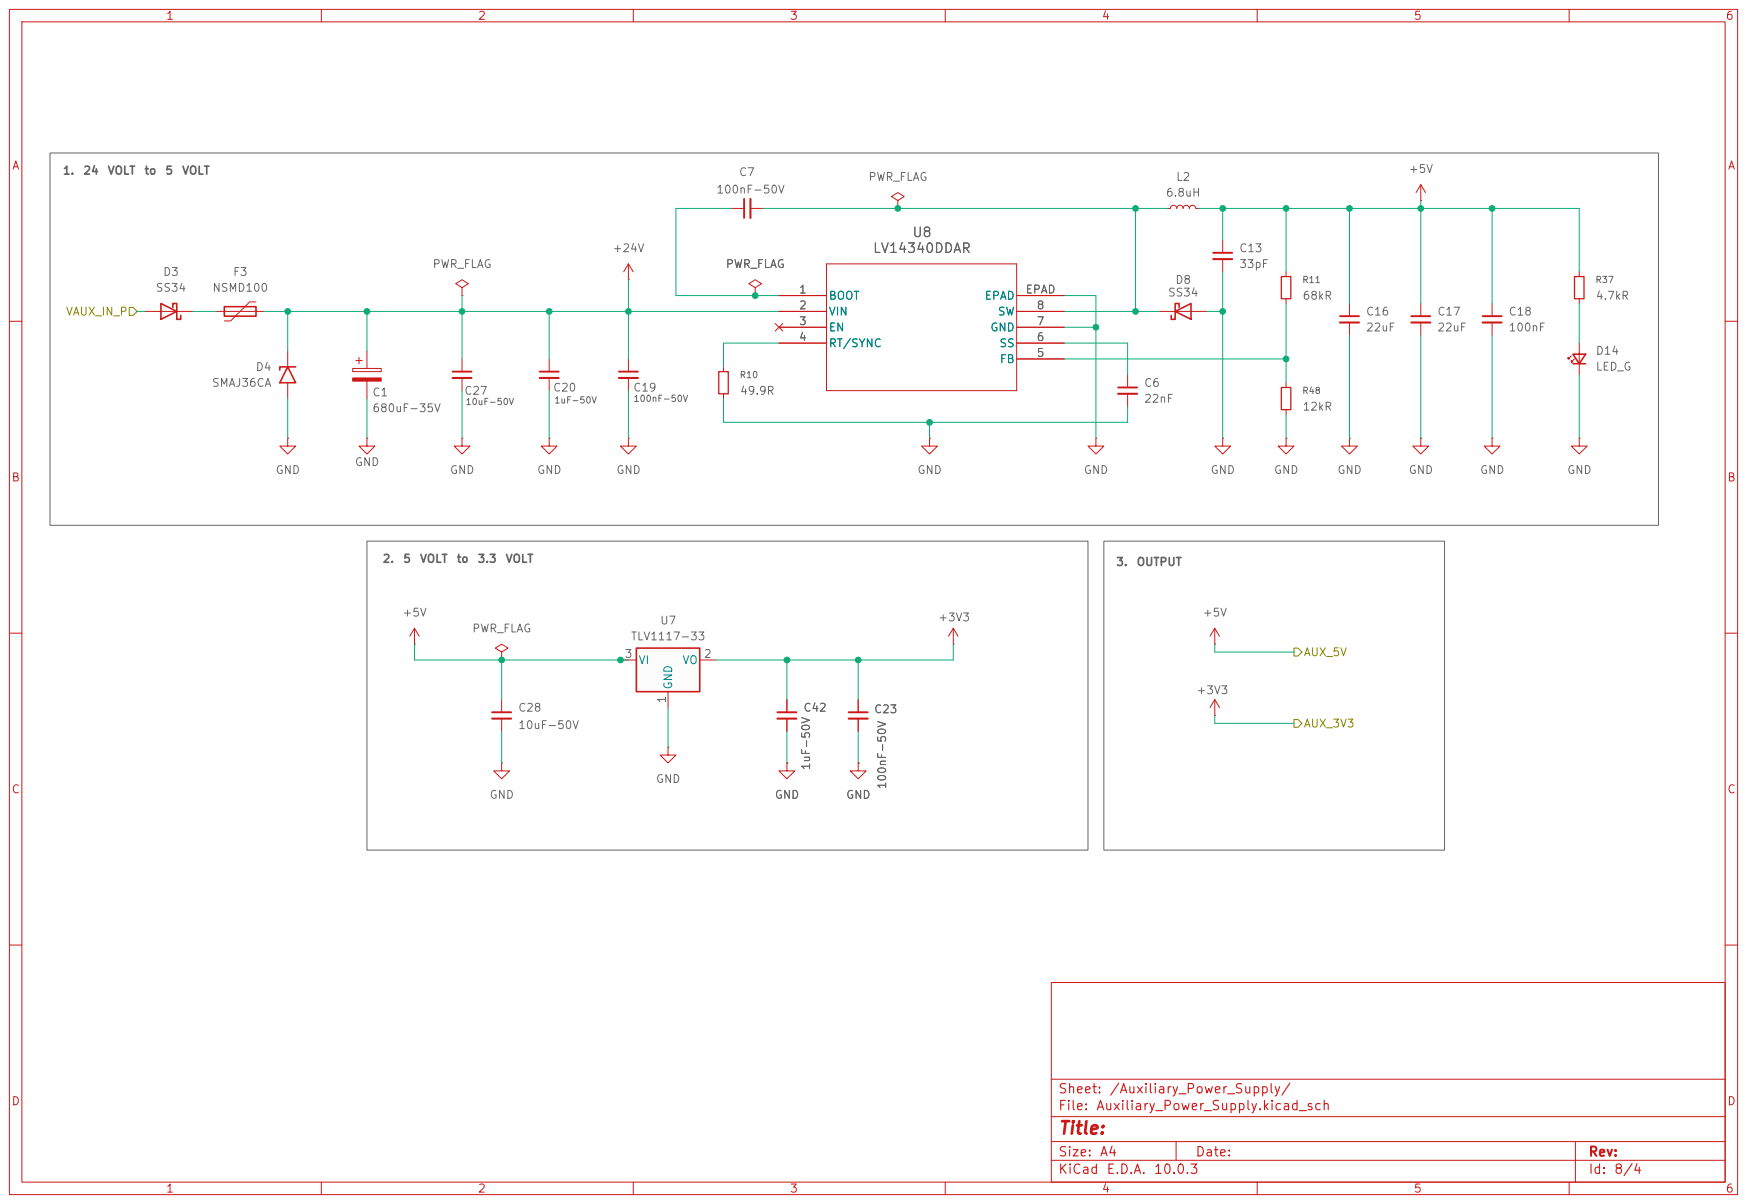
[picture p18: page 2]

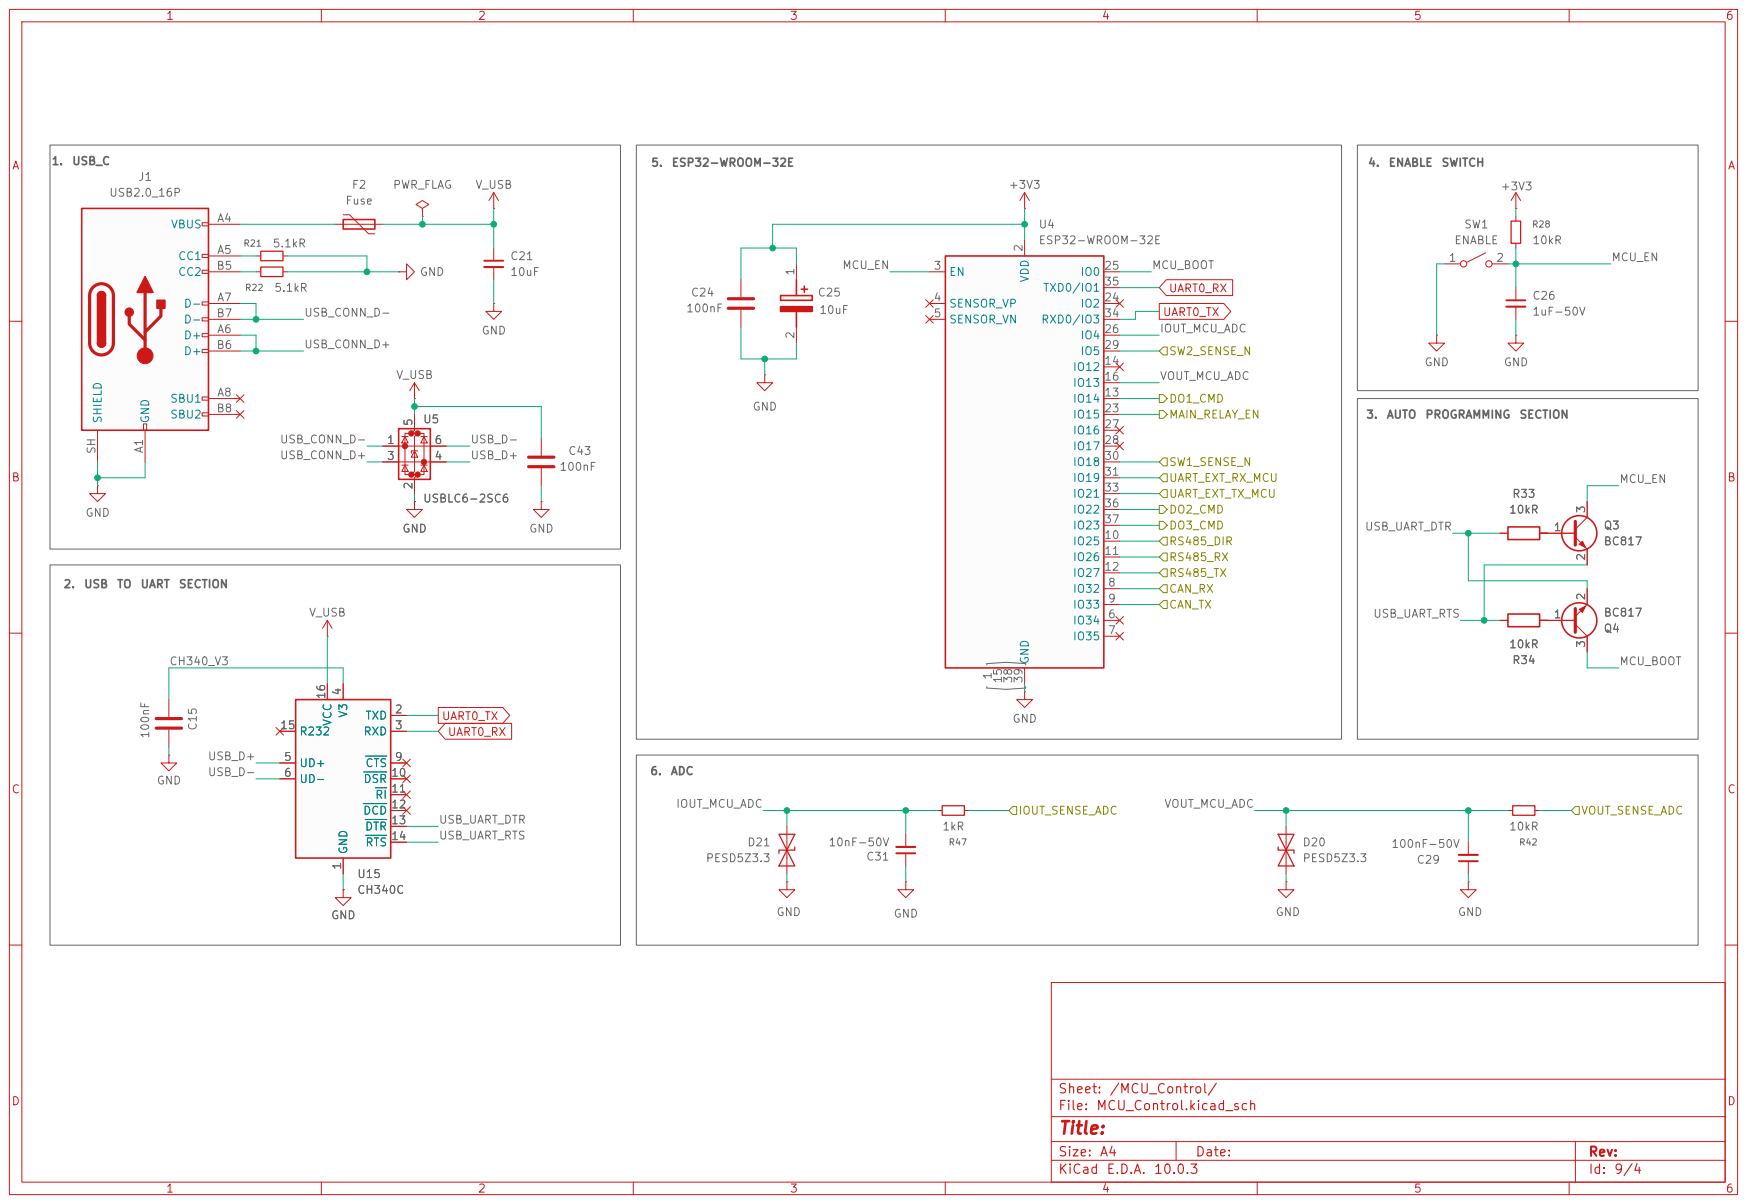
[picture p19: page 3]

2. USB TO UART SECTION

4 UD+ 5 UD- 6 CTS 9 DSR 10 RI 11 DCD 12 DTR 13 RTS 14 R232 15 VCC 16 U15 CH340C

4 UD+ 5 UD- 6 CTS 9 DSR 10 RI 11 DCD 12 DTR 13 RTS 14 R232 15 VCC 16 GND

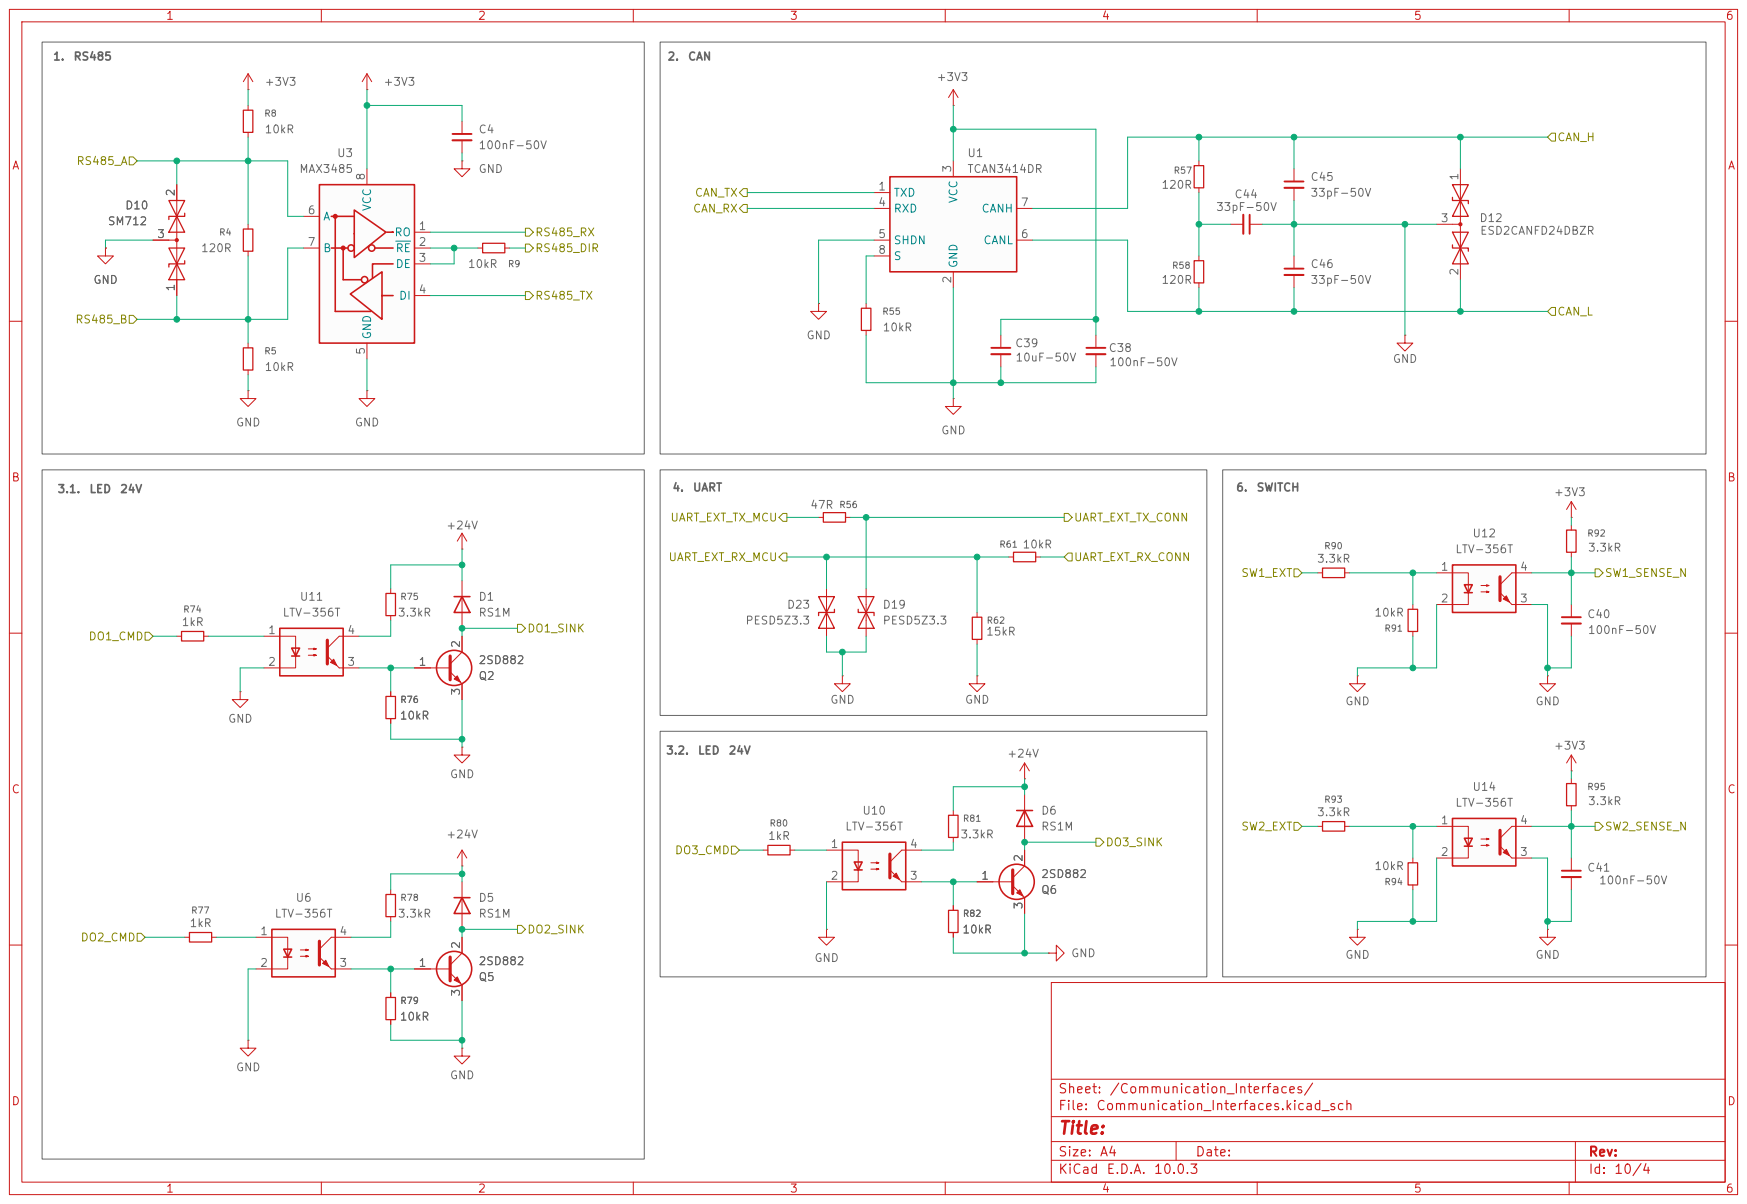
[picture p20: page 4]
