whoisLePhuc/robot_charge_controller/hardware/Split_Board_Design/Consolidated/Relay_board/Schematic.pdf

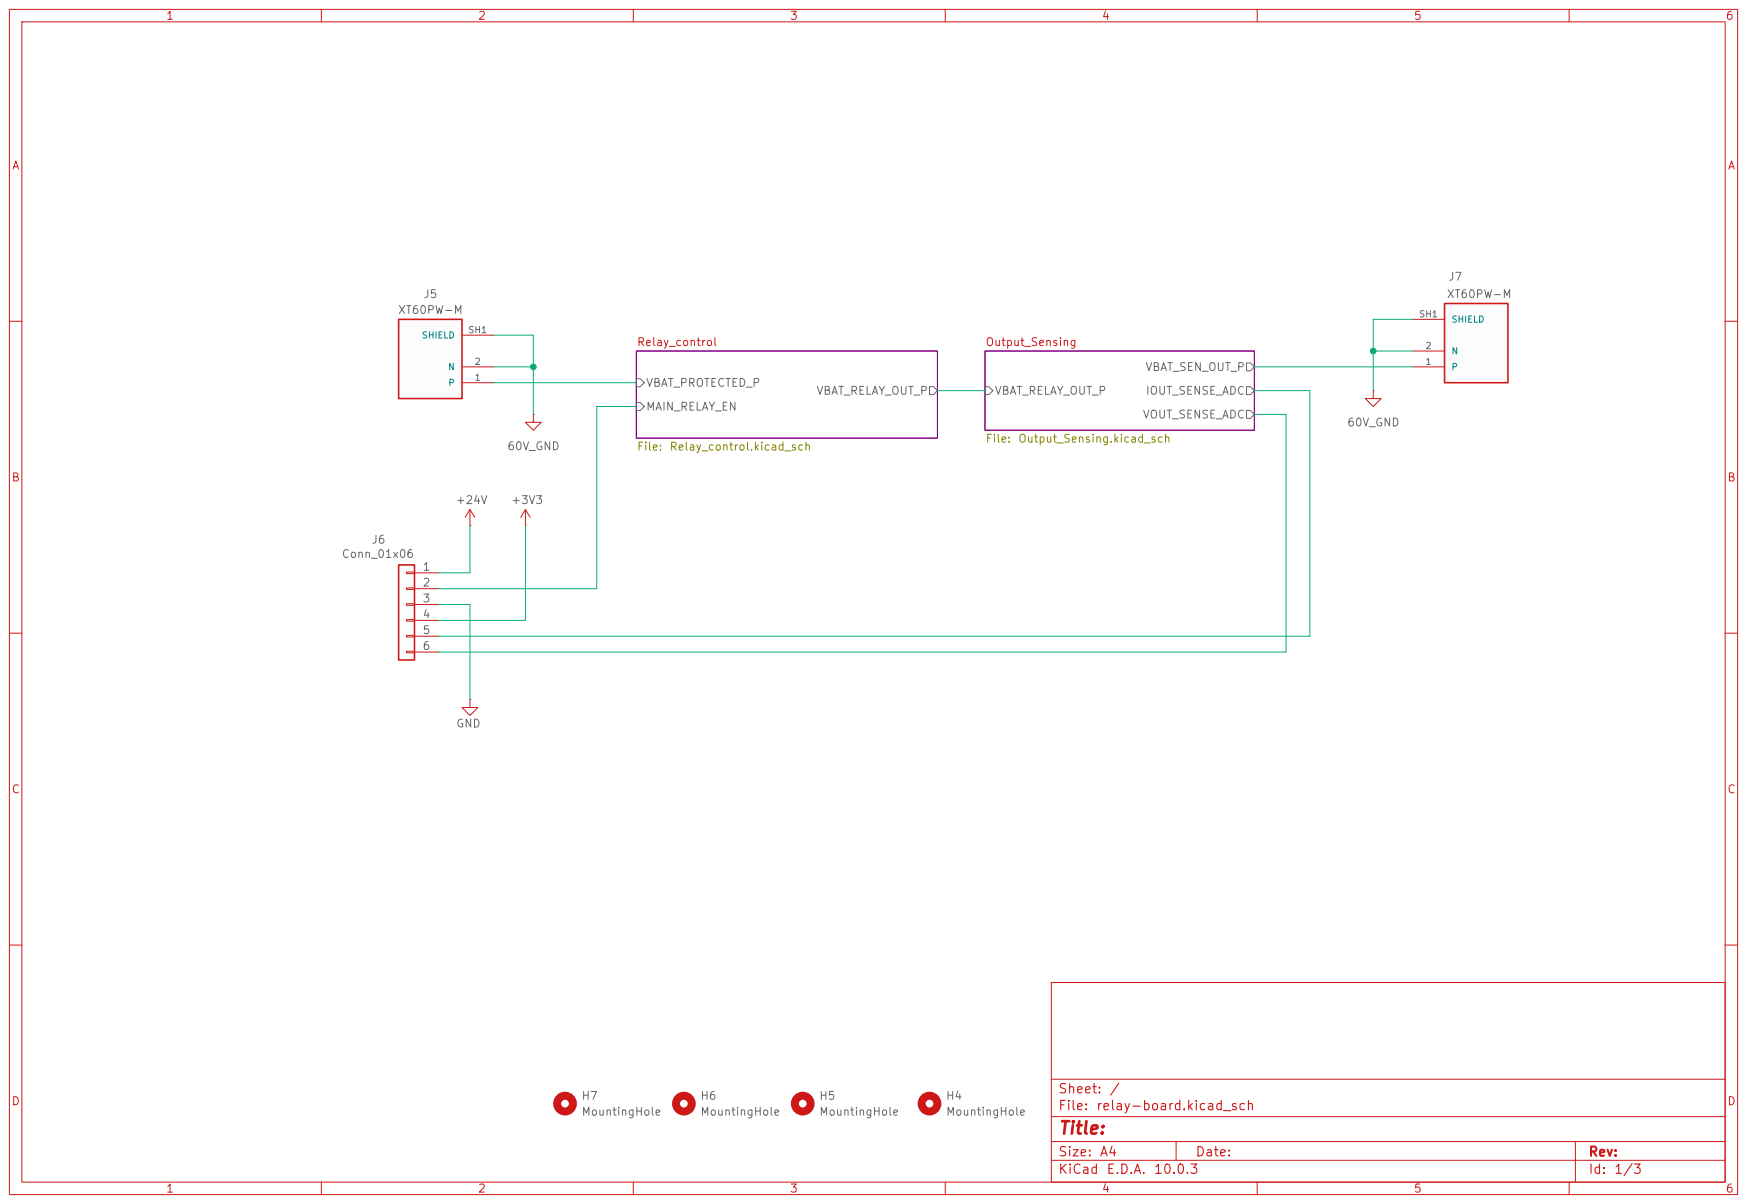
[picture p21: page 1]

Size: A4 | Rev:
KiCad E.D.A. 10.0.3 | Id: 1/3

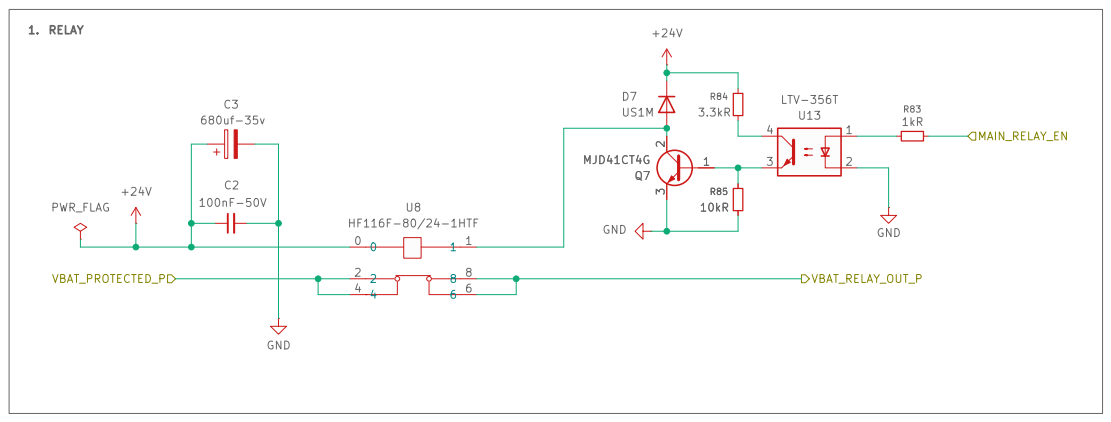
[picture p22: page 2]

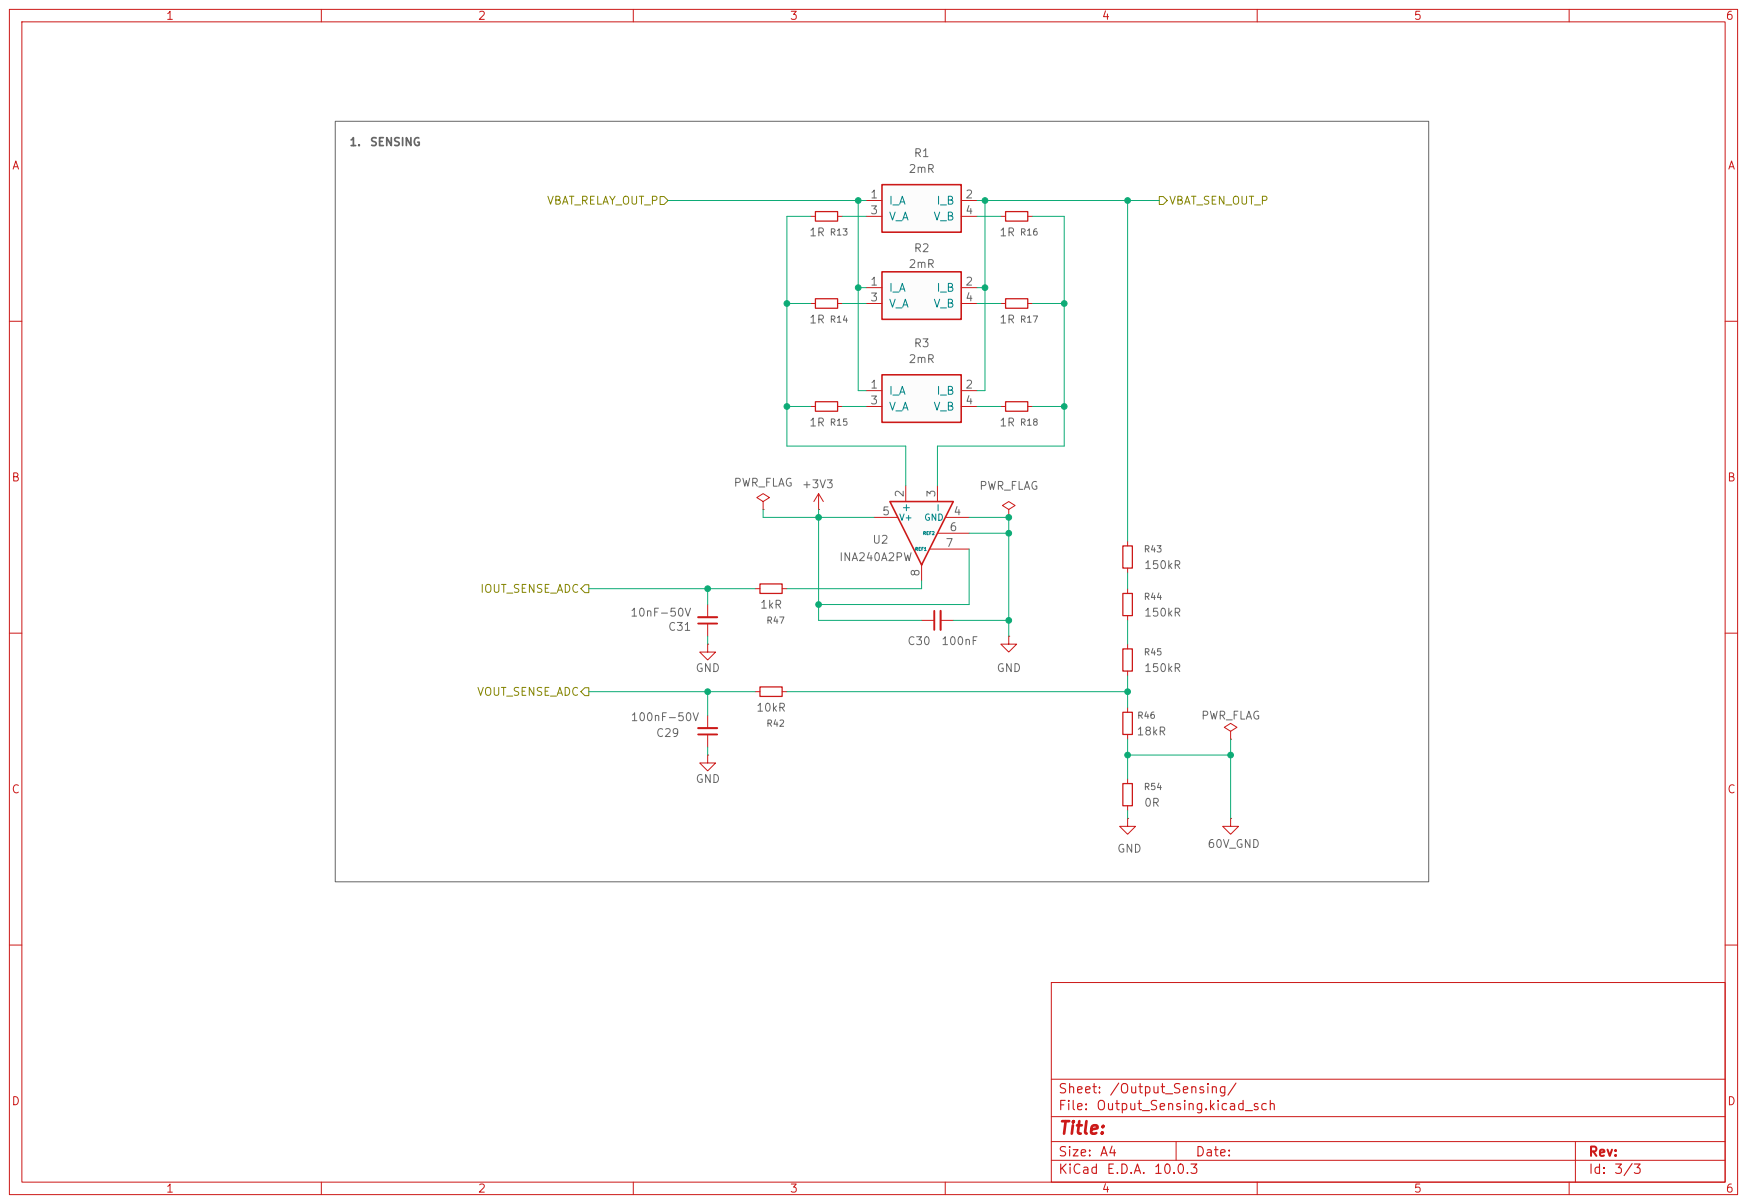
[picture p23: page 3]
