whoisLePhuc/robot_charge_controller/hardware/Split_Board_Design/Relay_Board/relay-board.kicad_pcb

## KiCad design hardware/Split_Board_Design/Relay_Board/relay-board.kicad_pcb (2026-09-05)

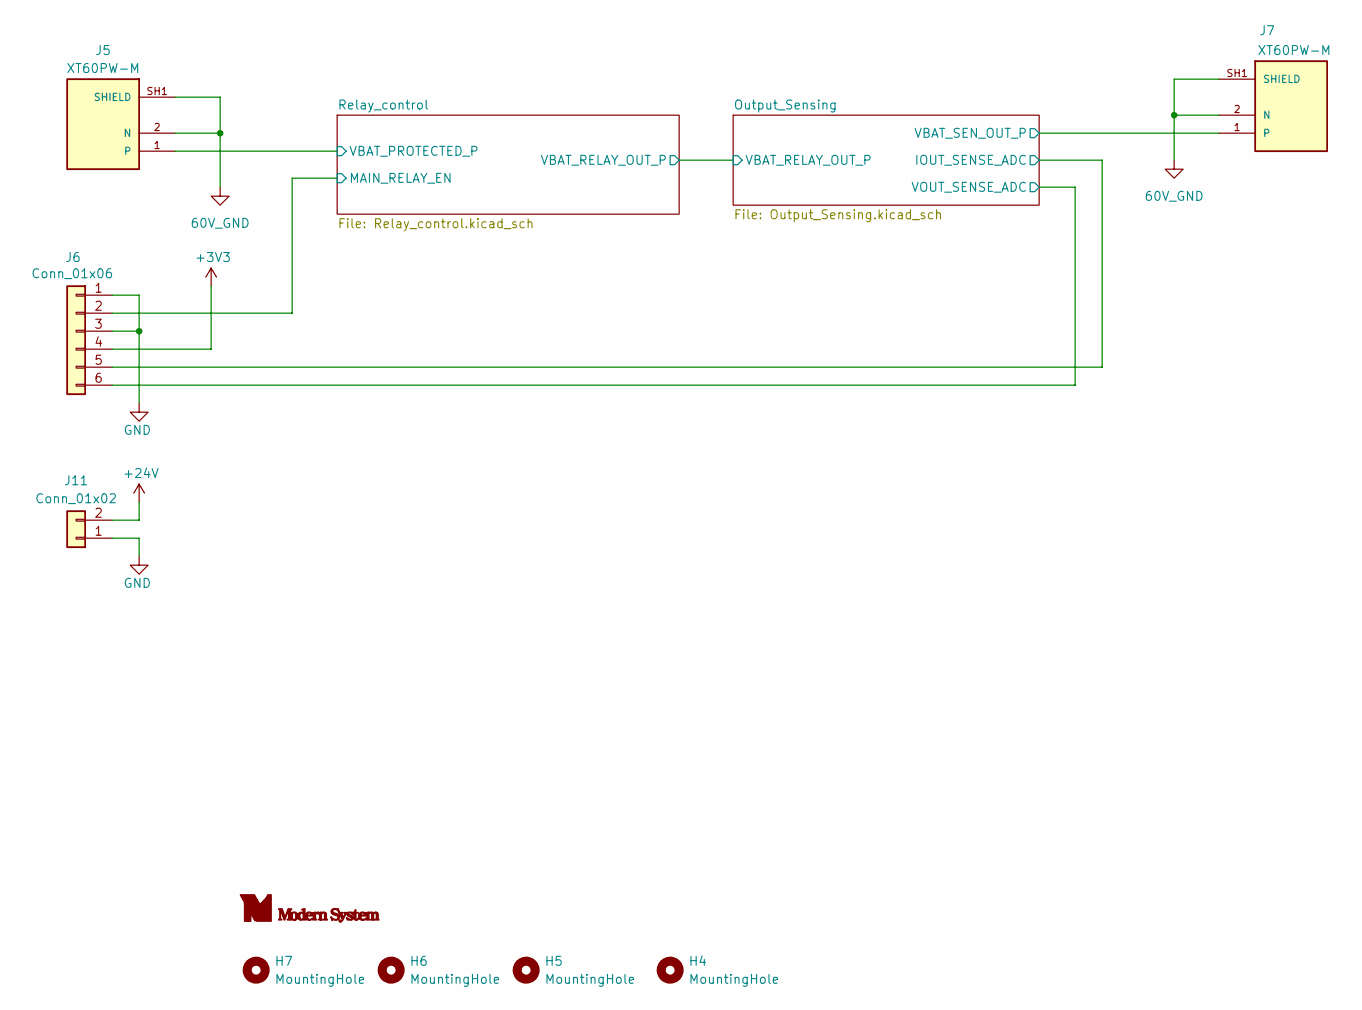
[picture p24: schematic relay-board.kicad_sch]

Parts:
H4, H5, H6, H7: MountingHole; MountingHole_3.2mm_M3
J5, J7: XT60PW-M; AMASS_XT60PW-M; PARTREV 1.2
J6: Conn_01x06; JST_XH_S6B-XH-A_1x06_P2.50mm_Horizontal
J11: Conn_01x02; PhoenixContact_MC_1,5_2-G-3.81_1x02_P3.81mm_Horizontal

Connections:
60V_GND: J5.2 (N), J5.SH1 (SHIELD), J5.SH2 (SHIELD), J7.2 (N), J7.SH1 (SHIELD), J7.SH2 (SHIELD); also elsewhere on the board
+3V3: J6.4; also elsewhere on the board
+24V: J11.2; also elsewhere on the board
/Output_Sensing/IOUT_SENSE_ADC: J6.5; also elsewhere on the board
/Output_Sensing/VBAT_SEN_OUT_P: J7.1; also elsewhere on the board
/Output_Sensing/VOUT_SENSE_ADC: J6.6; also elsewhere on the board
/Relay_control/MAIN_RELAY_EN: J6.2; also elsewhere on the board
/Relay_control/VBAT_PROTECTED_P: J5.1; also elsewhere on the board
GND: J6.1, J6.3, J11.1; also elsewhere on the board

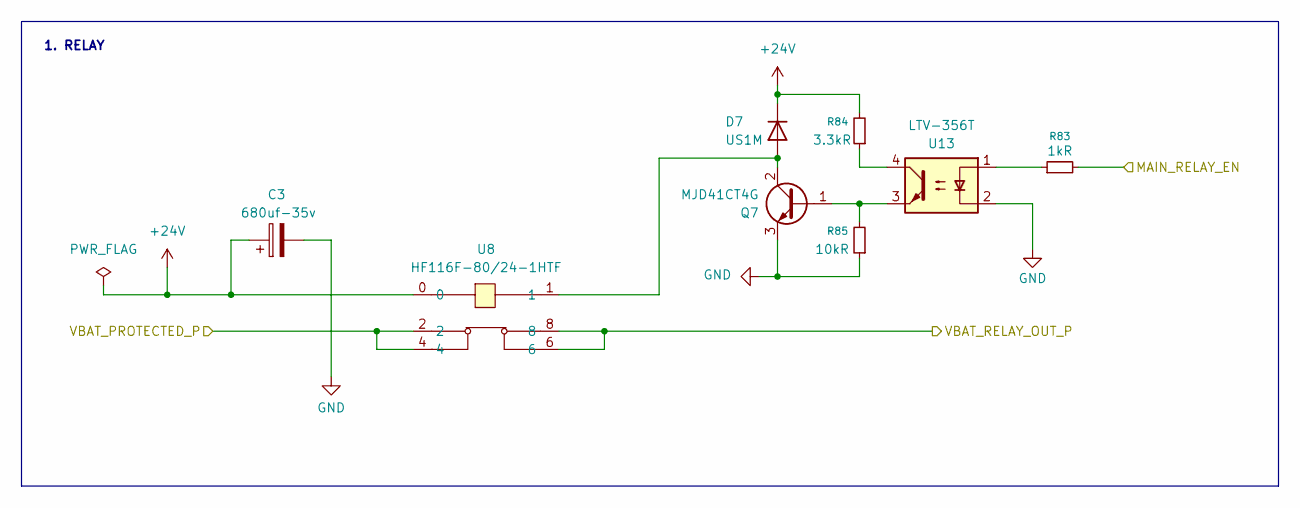
[picture p25: schematic Relay_control.kicad_sch]

Parts:
C3: 680uf-35v; CP_Elec_12.5x13.5_Generic_H13
D7: US1M; D_SMA
Q7: MJD41CT4G; TO-252-2
R83: 1kR; R_0805_2012Metric
R84: 3.3kR; R_0805_2012Metric
R85: 10kR; R_0805_2012Metric
U8: HF116F-80/24-1HTF; RELAY-TH_HF116F-80-XX-1HTF
U13: LTV-356T; SO-4_4.4x3.6mm_P2.54mm

Connections:
+24V: C3.1, D7.1 (K), R84.2, U8.0; also elsewhere on the board
/Output_Sensing/VBAT_RELAY_OUT_P: U8.6, U8.8; also elsewhere on the board
/Relay_control/MAIN_RELAY_EN: R83.2; also elsewhere on the board
/Relay_control/VBAT_PROTECTED_P: U8.2, U8.4; also elsewhere on the board
GND: C3.2, Q7.3 (E), R85.1, U13.2; also elsewhere on the board
unnamed: D7.2 (A), Q7.2 (C), U8.1
unnamed: Q7.1 (B), R85.2, U13.3
unnamed: R83.1, U13.1
unnamed: R84.1, U13.4

Notes on the sheet:
1. RELAY

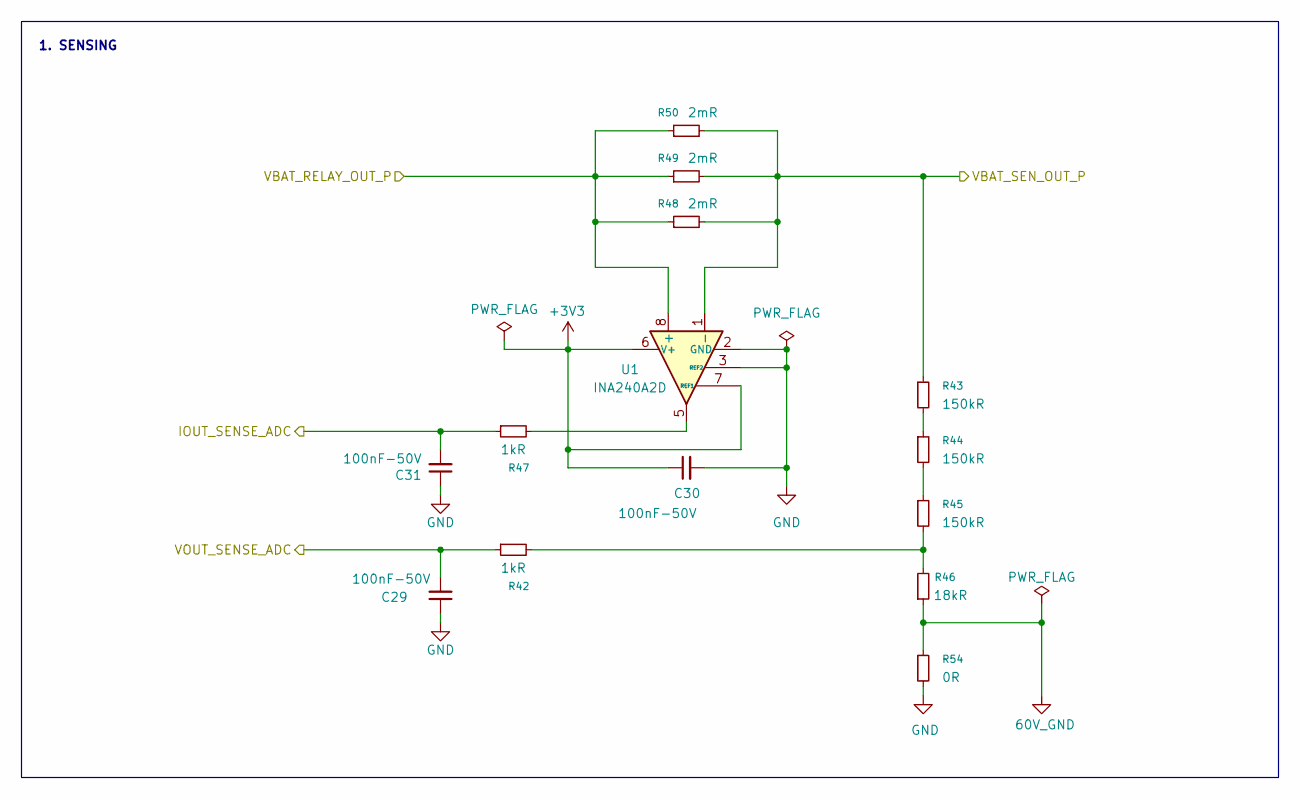
[picture p26: schematic Output_Sensing.kicad_sch]

Parts:
C29, C31: 100nF-50V; C_0603_1608Metric
C30: 100nF-50V; C_0805_2012Metric
R42, R47: 1kR; R_0603_1608Metric
R43, R44, R45: 150kR; R_0603_1608Metric
R46: 18kR; R_0603_1608Metric
R48, R49, R50: 2mR; R_Shunt_FOJAN_2512L_4Terminal_Kelvin_C
R54: 0R; R_1206_3216Metric
U1: INA240A2D; SOIC-8_3.9x4.9mm_P1.27mm

Connections:
60V_GND: R46.1, R54.1; also elsewhere on the board
+3V3: C30.1, U1.6 (V+), U1.7 (REF1); also elsewhere on the board
/Output_Sensing/IOUT_SENSE_ADC: C31.2, R47.1; also elsewhere on the board
/Output_Sensing/VBAT_RELAY_OUT_P: R48.1, R49.1, R50.1, U1.8 (+); also elsewhere on the board
/Output_Sensing/VBAT_SEN_OUT_P: R43.1, R48.2, R49.2, R50.2, U1.1 (-); also elsewhere on the board
/Output_Sensing/VOUT_SENSE_ADC: C29.2, R42.1; also elsewhere on the board
GND: C29.1, C30.2, C31.1, R54.2, U1.2 (GND), U1.3 (REF2), U1.4 (GND); also elsewhere on the board
unnamed: R42.2, R45.2, R46.2
unnamed: R43.2, R44.1
unnamed: R44.2, R45.1
unnamed: R47.2, U1.5

Notes on the sheet:
1. SENSING

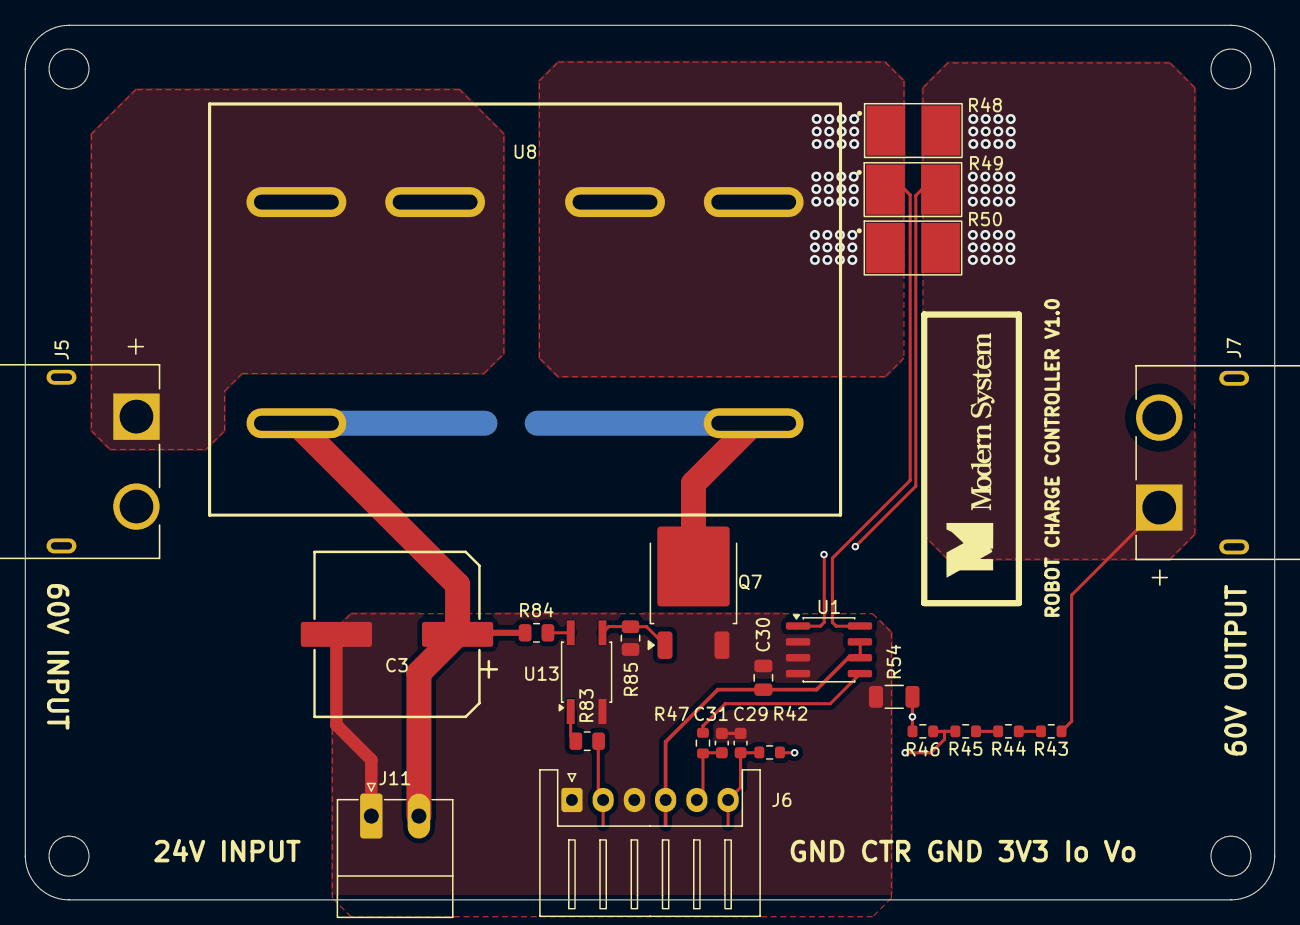
[picture p27: board relay-board.kicad_pcb from above]

Board: 4 copper layers, 100.0 x 70.0 mm, 30 parts (1 on the bottom side), 18 nets.
