whoisLePhuc/robot_charge_controller/hardware/Split_Board_Design/Control_Board/control-board.kicad_pcb

## KiCad design hardware/Split_Board_Design/Control_Board/control-board.kicad_pcb (2026-09-05)

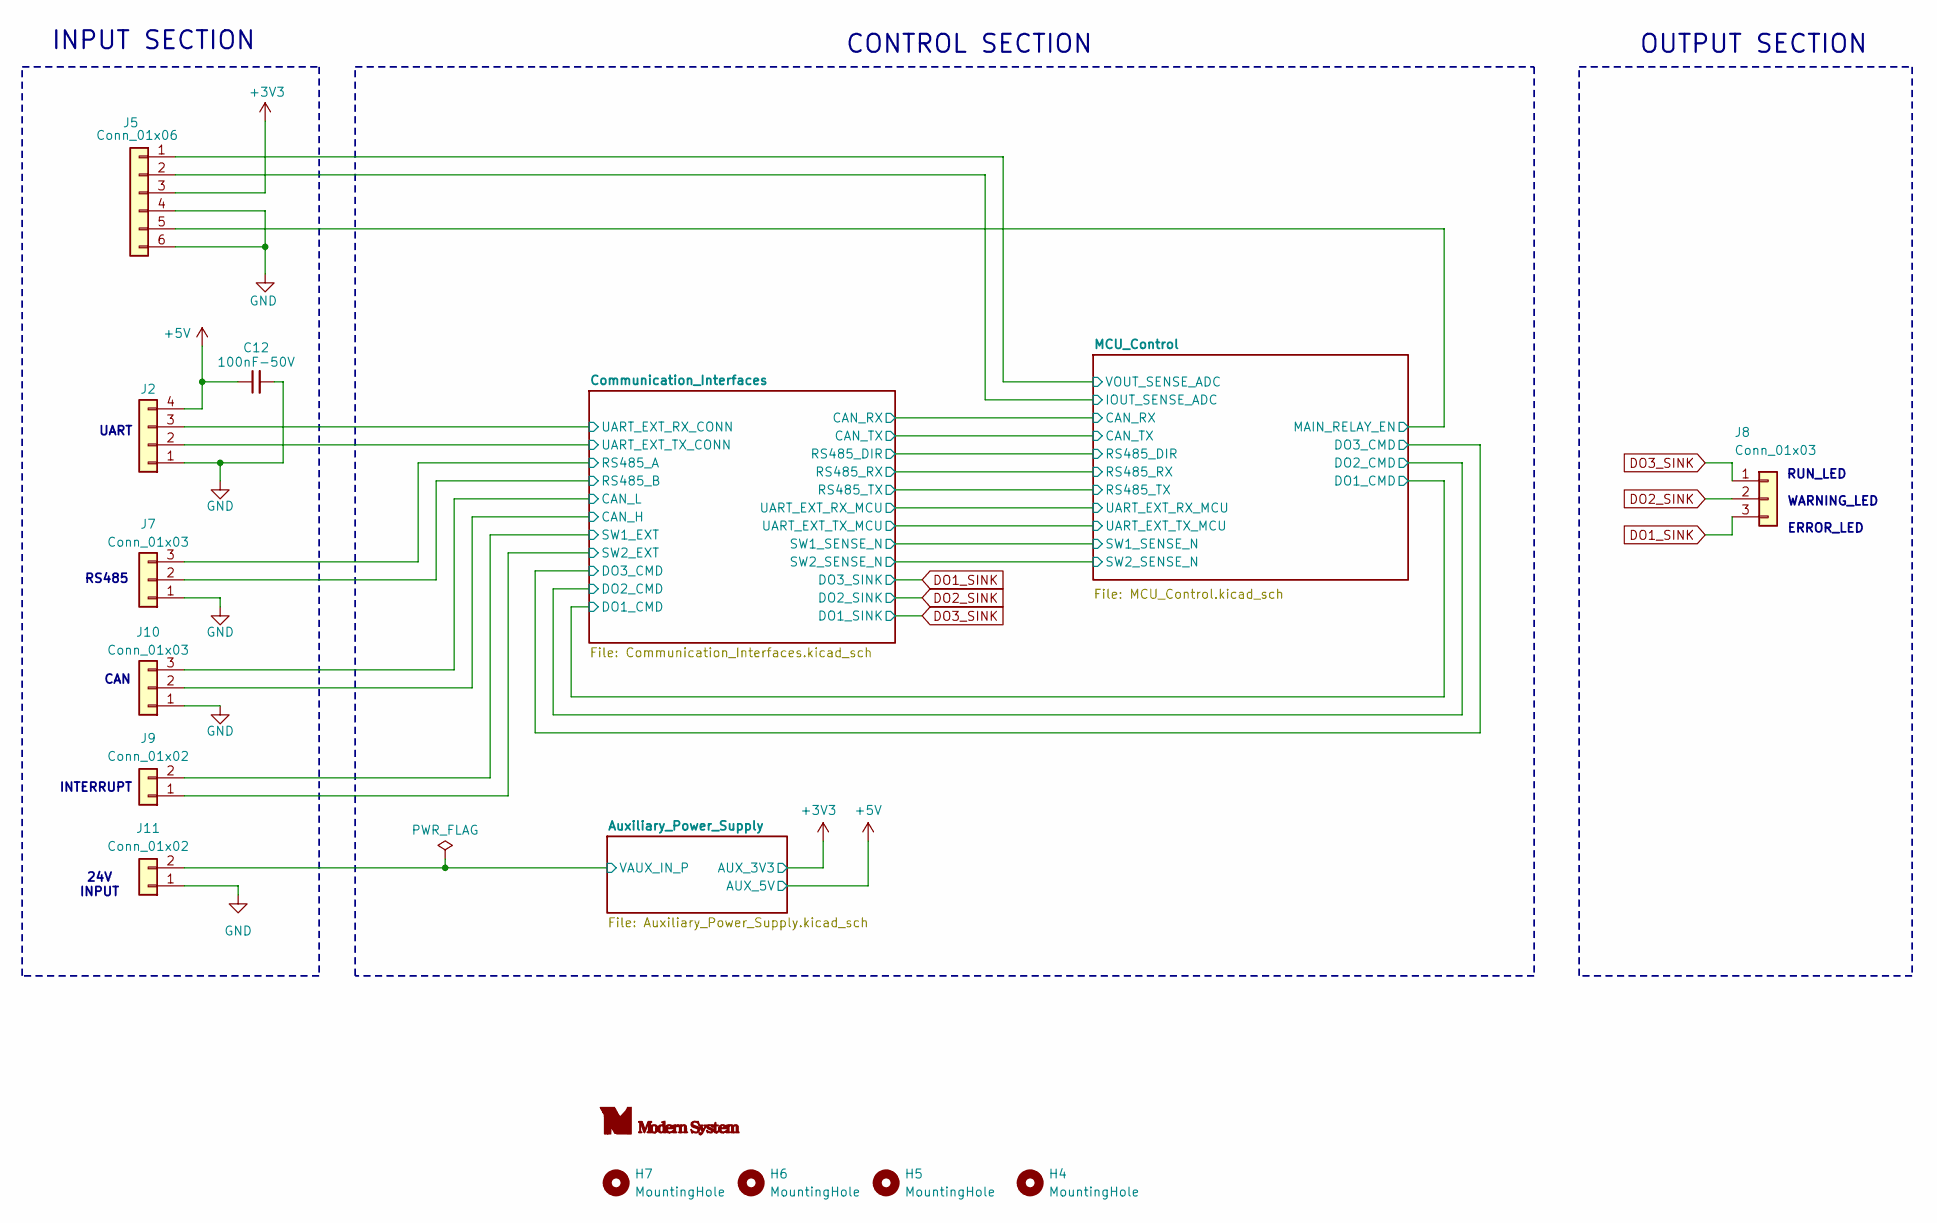
[picture p28: schematic control-board.kicad_sch]

Parts:
C12: 100nF-50V; C_0603_1608Metric
H4, H5, H6, H7: MountingHole; MountingHole_3.2mm_M3
J2: UART_CONN; JST_XH_S4B-XH-A-1_1x04_P2.50mm_Horizontal; MPN XH2.54-4P (bent pin)
J5: Conn_01x06; JST_XH_S6B-XH-A_1x06_P2.50mm_Horizontal
J7, J8, J10: Conn_01x03; PhoenixContact_MC_1,5_3-G-3.81_1x03_P3.81mm_Horizontal
J9, J11: Conn_01x02; PhoenixContact_MC_1,5_2-G-3.81_1x02_P3.81mm_Horizontal

Connections:
+3V3: J5.3; also elsewhere on the board
+5V: C12.1, J2.4; also elsewhere on the board
/Auxiliary_Power_Supply/VAUX_IN_P: J11.2; also elsewhere on the board
/Communication_Interfaces/CAN_H: J10.2; also elsewhere on the board
/Communication_Interfaces/CAN_L: J10.3; also elsewhere on the board
/Communication_Interfaces/RS485_A: J7.3; also elsewhere on the board
/Communication_Interfaces/RS485_B: J7.2; also elsewhere on the board
/Communication_Interfaces/SW1_EXT: J9.2; also elsewhere on the board
/Communication_Interfaces/SW2_EXT: J9.1; also elsewhere on the board
/Communication_Interfaces/UART_EXT_RX_CONN: J2.3; also elsewhere on the board
/Communication_Interfaces/UART_EXT_TX_CONN: J2.2; also elsewhere on the board
/MCU_Control/IOUT_SENSE_ADC: J5.2; also elsewhere on the board
/MCU_Control/MAIN_RELAY_EN: J5.5; also elsewhere on the board
/MCU_Control/VOUT_SENSE_ADC: J5.1; also elsewhere on the board
DO1_SINK: J8.3; also elsewhere on the board
DO2_SINK: J8.2; also elsewhere on the board
DO3_SINK: J8.1; also elsewhere on the board
GND: C12.2, J2.1, J5.4, J5.6, J7.1, J10.1, J11.1; also elsewhere on the board

Notes on the sheet:
OUTPUT SECTION
INPUT SECTION
RUN_LED
RS485
WARNING_LED
CONTROL SECTION
INTERRUPT
UART
ERROR_LED
24V INPUT
CAN

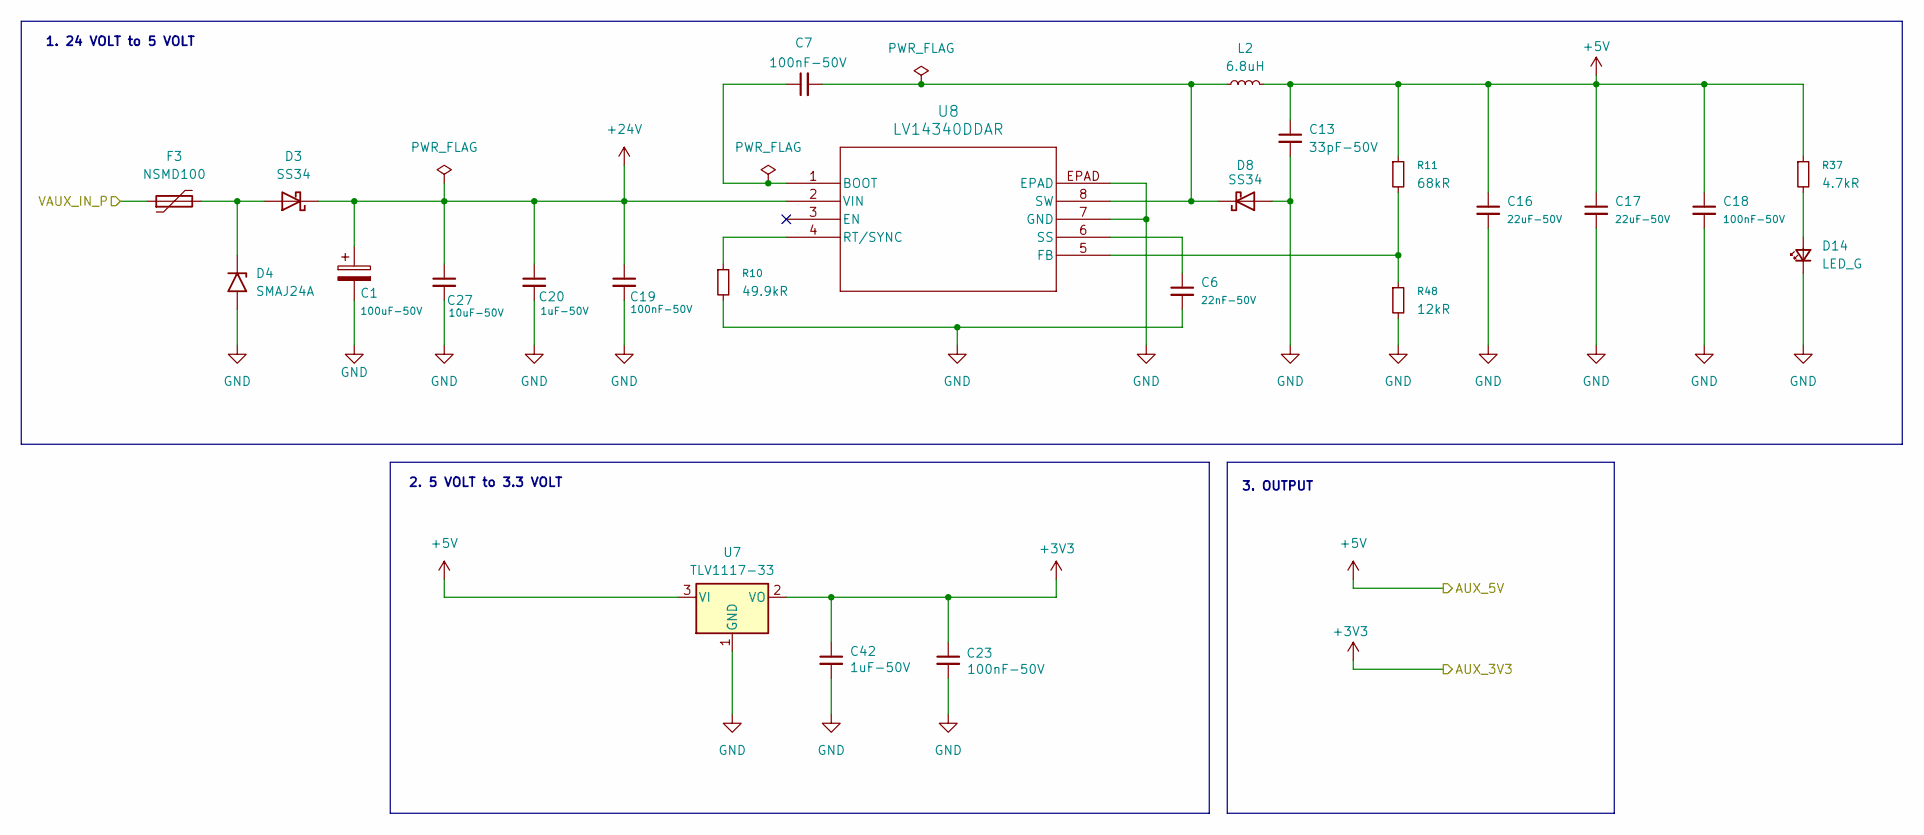
[picture p29: schematic Auxiliary_Power_Supply.kicad_sch]

Parts:
C1: 100uF-50V; CP_Elec_8x10.5
C6: 22nF-50V; C_0603_1608Metric
C7, C18, C19, C23: 100nF-50V; C_0603_1608Metric
C13: 33pF-50V; C_0603_1608Metric
C16, C17: 22uF-50V; C_0805_2012Metric
C20, C42: 1uF-50V; C_0603_1608Metric
C27: 10uF-50V; C_0603_1608Metric
D3, D8: SS34; D_SMA; LCSC Part C2837271
D4: SMAJ24A; D_SMA
D14: LED_G; LED_0603_1608Metric
F3: NSMD100; Fuse_1206_3216Metric; MPN nSMD100; LCSC Part C66453
L2: 6.8uH; L_Changjiang_FXL0630
R10: 49.9kR; R_0603_1608Metric
R11: 68kR; R_0603_1608Metric
R37: 4.7kR; R_0603_1608Metric
R48: 12kR; R_0603_1608Metric
U7: TLV1117-33; SOT-223-3_TabPin2
U8: LV14340DDAR; SOIC8_DDA_TEX

Connections:
+3V3: C23.1, C42.1, U7.2 (VO); also elsewhere on the board
+5V: C13.1, C16.1, C17.1, C18.1, L2.2, R11.1, R37.1, U7.3 (VI); also elsewhere on the board
+24V: C1.1, C19.1, C20.1, C27.1, D3.1 (K), U8.2 (VIN); also elsewhere on the board
/Auxiliary_Power_Supply/VAUX_IN_P: F3.1; also elsewhere on the board
GND: C1.2, C6.2, C13.2, C16.2, C17.2, C18.2, C19.2, C20.2, C23.2, C27.2, C42.2, D4.2 (A2), D8.2 (A), D14.1 (K), R10.2, R48.2, U7.1 (GND), U8.7 (GND), U8.EPAD; also elsewhere on the board
unnamed: D3.2 (A), D4.1 (A1), F3.2
unnamed: C7.2, D8.1 (K), L2.1, U8.8 (SW)
unnamed: D14.2 (A), R37.2
unnamed: C7.1, U8.1 (BOOT)
unnamed: R11.2, R48.1, U8.5 (FB)
unnamed: R10.1, U8.4 (RT/SYNC)
unnamed: C6.1, U8.6 (SS)

Notes on the sheet:
2. 5 VOLT to 3.3 VOLT
1. 24 VOLT to 5 VOLT
3. OUTPUT

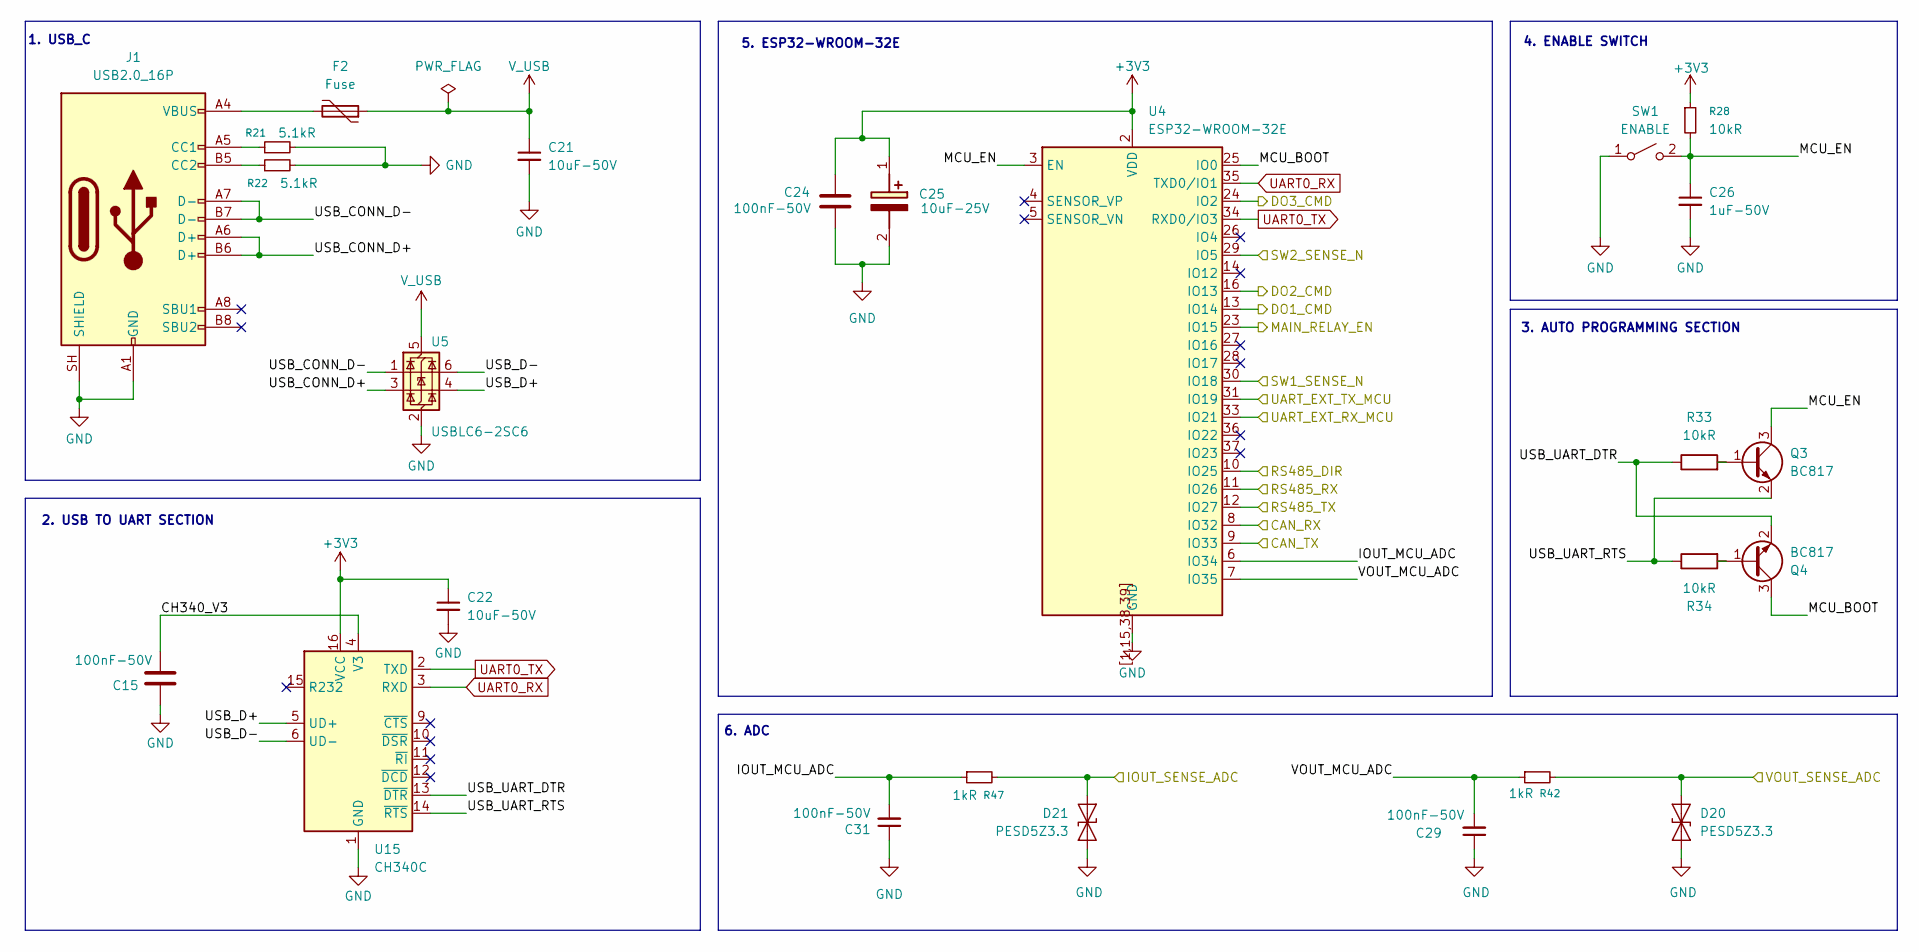
[picture p30: schematic MCU_Control.kicad_sch]

Parts:
C15, C24: 100nF-50V; C_0603_1608Metric; Voltage 1kV; Tolerance 100%
C21, C22: 10uF-50V; C_0603_1608Metric
C25: 10uF-25V; CP_EIA-3528-12_Kemet-T; Voltage 1kV; Tolerance 100%; Manufacturer_Part_Number T491A106K010AT7280; Mouser Part Number 80-T491A106K107280
C26: 1uF-50V; C_0603_1608Metric
C29, C31: 100nF-50V; C_0603_1608Metric
D20: PESD5Z3.3; D_SOD-523
D21: PESD5Z3.3; D_SOD-523; MPN PESD5Z3.3
F2: Fuse; Fuse_1206_3216Metric; MPN nSMD100; LCSC Part C66453
J1: USB2.0_16P; USB_C_Receptacle_GCT_USB4105-xx-A_16P_TopMnt_Horizontal; MPN USB4105-GF-A
Q3, Q4: BC817; SOT-23-3; Manufacturer_Part_Number BC817
R21, R22: 5.1kR; R_0603_1608Metric
R28, R33, R34: 10kR; R_0603_1608Metric
R42, R47: 1kR; R_0603_1608Metric
SW1: ENABLE; SW_SPST_B3U-1000P; MPN B3U-1000P; LCSC Part C231329
U4: ESP32-WROOM-32E; ESP32-WROOM-32UE; MPN ESP32-WROOM-32E
U5: USBLC6-2SC6; SOT-23-6; MPN USBLC6-2SC6; LCSC Part C7519
U15: CH340C; SOIC-16_3.9x9.9mm_P1.27mm

Connections:
+3V3: C22.1, C24.1, C25.1 (+), R28.1, U4.2 (VDD), U15.16 (VCC); also elsewhere on the board
/Communication_Interfaces/CAN_RX: U4.8 (IO32); also elsewhere on the board
/Communication_Interfaces/CAN_TX: U4.9 (IO33); also elsewhere on the board
/Communication_Interfaces/DO1_CMD: U4.13 (IO14); also elsewhere on the board
/Communication_Interfaces/DO2_CMD: U4.16 (IO13); also elsewhere on the board
/Communication_Interfaces/DO3_CMD: U4.24 (IO2); also elsewhere on the board
/Communication_Interfaces/RS485_DIR: U4.10 (IO25); also elsewhere on the board
/Communication_Interfaces/RS485_RX: U4.11 (IO26); also elsewhere on the board
/Communication_Interfaces/RS485_TX: U4.12 (IO27); also elsewhere on the board
/Communication_Interfaces/SW1_SENSE_N: U4.30 (IO18); also elsewhere on the board
/Communication_Interfaces/SW2_SENSE_N: U4.29 (IO5); also elsewhere on the board
/Communication_Interfaces/UART_EXT_RX_MCU: U4.33 (IO21); also elsewhere on the board
/Communication_Interfaces/UART_EXT_TX_MCU: U4.31 (IO19); also elsewhere on the board
/MCU_Control/CH340_V3: C15.1, U15.4 (V3)
/MCU_Control/IOUT_MCU_ADC: C31.2, R47.1, U4.6 (IO34)
/MCU_Control/IOUT_SENSE_ADC: D21.1 (A1), R47.2; also elsewhere on the board
/MCU_Control/MAIN_RELAY_EN: U4.23 (IO15); also elsewhere on the board
/MCU_Control/MCU_BOOT: Q4.3 (C), U4.25 (IO0)
/MCU_Control/MCU_EN: C26.1, Q3.3 (C), R28.2, SW1.2 (B), U4.3 (EN)
/MCU_Control/USB_CONN_D+: J1.A6 (D+), J1.B6 (D+), U5.3 (I/O2)
/MCU_Control/USB_CONN_D-: J1.A7 (D-), J1.B7 (D-), U5.1 (I/O1)
/MCU_Control/USB_D+: U5.4 (I/O2), U15.5 (UD+)
/MCU_Control/USB_D-: U5.6 (I/O1), U15.6 (UD-)
/MCU_Control/USB_UART_DTR: Q4.2 (E), R33.1, U15.13 (~DTR)
/MCU_Control/USB_UART_RTS: Q3.2 (E), R34.1, U15.14 (~RTS)
/MCU_Control/VOUT_MCU_ADC: C29.2, R42.1, U4.7 (IO35)
/MCU_Control/VOUT_SENSE_ADC: D20.1 (A1), R42.2; also elsewhere on the board
GND: C15.2, C21.2, C22.2, C24.2, C25.2 (-), C26.2, C29.1, C31.1, D20.2 (A2), D21.2 (A2), J1.A1 (GND), J1.A12 (GND), J1.B1 (GND), J1.B12 (GND), J1.SH (SHIELD), R21.2, R22.2, SW1.1 (A), U4.1 (GND), U4.15 (GND), U4.38 (GND), U4.39 (GND), U4.[1,15,38,39] (GND), U5.2 (GND), U15.1 (GND); also elsewhere on the board
unnamed: F2.2, J1.A4 (VBUS), J1.A9 (VBUS), J1.B4 (VBUS), J1.B9 (VBUS)
unnamed: J1.A5 (CC1), R21.1
unnamed: J1.B5 (CC2), R22.1
unnamed: Q3.1 (B), R33.2
unnamed: Q4.1 (B), R34.2
UART0_RX: U4.35 (TXD0/IO1), U15.3 (RXD)
UART0_TX: U4.34 (RXD0/IO3), U15.2 (TXD)
V_USB: C21.1, F2.1, U5.5 (VBUS)

Notes on the sheet:
2. USB TO UART SECTION
5. ESP32-WROOM-32E
1. USB_C
6. ADC
3. AUTO PROGRAMMING SECTION
4. ENABLE SWITCH

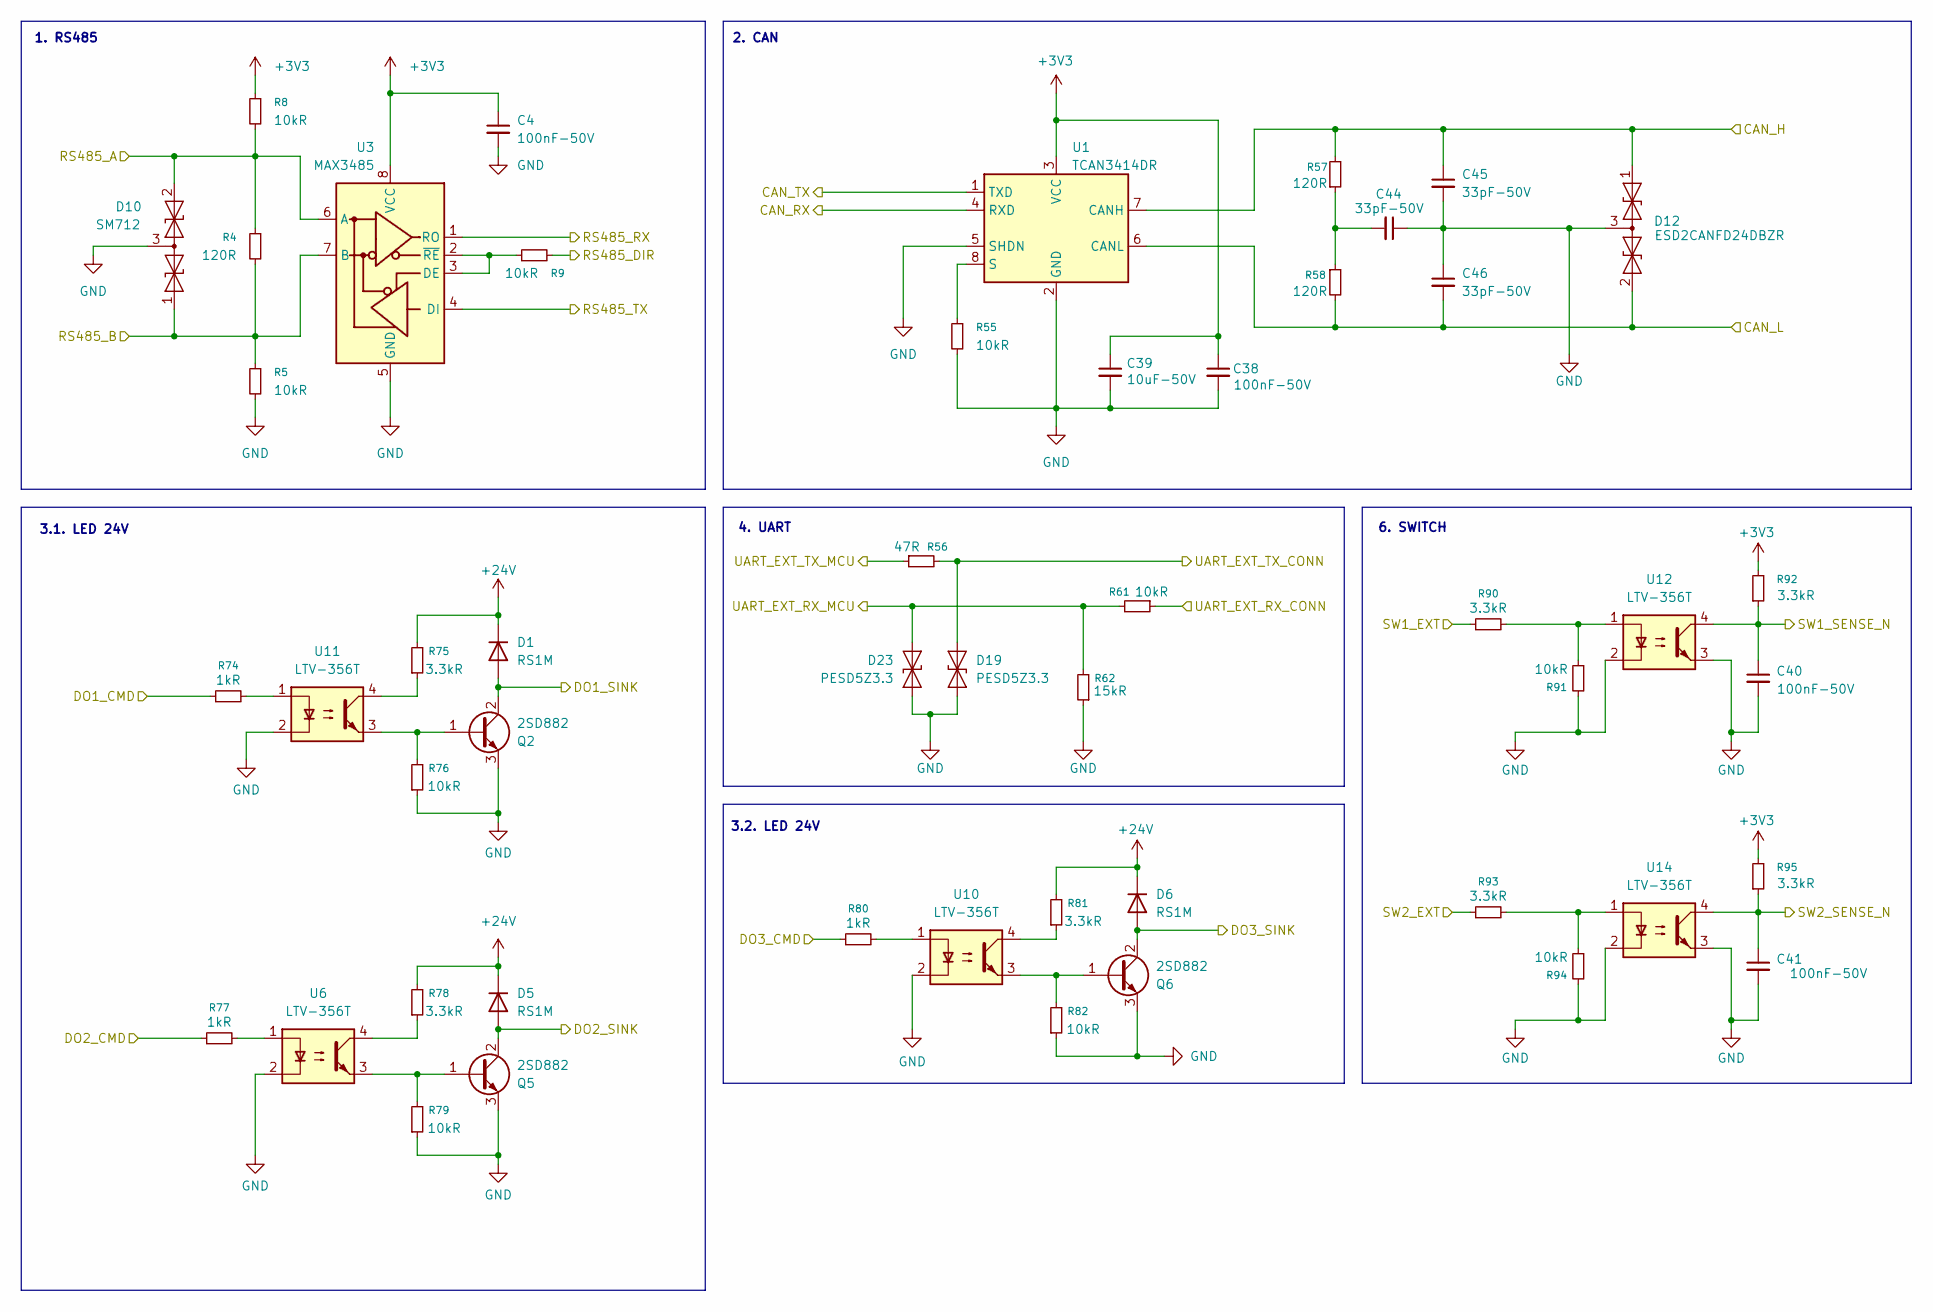
[picture p31: schematic Communication_Interfaces.kicad_sch]

Parts:
C4, C38, C40, C41: 100nF-50V; C_0603_1608Metric
C39: 10uF-50V; C_0603_1608Metric
C44, C45, C46: 33pF-50V; C_0603_1608Metric
D1, D5, D6: RS1M; D_SOD-123; MPN RS1M
D10: SM712; SOT-23; MPN SM712
D12: ESD2CANFD24DBZR; SOT-23; MPN ESD2CANFD24DBZR
D19, D23: PESD5Z3.3; D_SOD-523
Q2, Q5, Q6: 2SD882; SOT-89-3
R4, R57, R58: 120R; R_0603_1608Metric
R5, R8, R9, R55, R61, R82, R91, R94: 10kR; R_0603_1608Metric
R56: 47R; R_0603_1608Metric
R62: 15kR; R_0603_1608Metric
R74, R77, R80: 1kR; R_0603_1608Metric
R75, R78, R81, R90, R92, R93, R95: 3.3kR; R_0603_1608Metric
R76, R79: 10kR; R_0805_2012Metric
U1: TCAN3414DR; SOIC-8_3.9x4.9mm_P1.27mm
U3: MAX3485; SOIC-8_3.9x4.9mm_P1.27mm; MPN MAX3485CSA; LCSC Part C18148
U6, U10, U11, U12, U14: LTV-356T; SO-4_4.4x3.6mm_P2.54mm

Connections:
+3V3: C4.1, C38.1, C39.1, R8.1, R92.2, R95.2, U1.3 (VCC), U3.8 (VCC); also elsewhere on the board
+24V: D1.1 (K), D5.1 (K), D6.1 (K), R75.2, R78.2, R81.2; also elsewhere on the board
/Communication_Interfaces/CAN_H: C45.1, D12.1 (A1), R57.2, U1.7 (CANH); also elsewhere on the board
/Communication_Interfaces/CAN_L: C46.2, D12.2 (A2), R58.2, U1.6 (CANL); also elsewhere on the board
/Communication_Interfaces/CAN_RX: U1.4 (RXD); also elsewhere on the board
/Communication_Interfaces/CAN_TX: U1.1 (TXD); also elsewhere on the board
/Communication_Interfaces/DO1_CMD: R74.1; also elsewhere on the board
/Communication_Interfaces/DO2_CMD: R77.1; also elsewhere on the board
/Communication_Interfaces/DO3_CMD: R80.1; also elsewhere on the board
/Communication_Interfaces/RS485_A: D10.2 (A2), R4.1, R8.2, U3.6 (A); also elsewhere on the board
/Communication_Interfaces/RS485_B: D10.1 (A1), R4.2, R5.1, U3.7 (B); also elsewhere on the board
/Communication_Interfaces/RS485_DIR: R9.2; also elsewhere on the board
/Communication_Interfaces/RS485_RX: U3.1 (RO); also elsewhere on the board
/Communication_Interfaces/RS485_TX: U3.4 (DI); also elsewhere on the board
/Communication_Interfaces/SW1_EXT: R90.1; also elsewhere on the board
/Communication_Interfaces/SW1_SENSE_N: C40.1, R92.1, U12.4; also elsewhere on the board
/Communication_Interfaces/SW2_EXT: R93.1; also elsewhere on the board
/Communication_Interfaces/SW2_SENSE_N: C41.1, R95.1, U14.4; also elsewhere on the board
/Communication_Interfaces/UART_EXT_RX_CONN: R61.1; also elsewhere on the board
/Communication_Interfaces/UART_EXT_RX_MCU: D23.1 (A1), R61.2, R62.2; also elsewhere on the board
/Communication_Interfaces/UART_EXT_TX_CONN: D19.1 (A1), R56.2; also elsewhere on the board
/Communication_Interfaces/UART_EXT_TX_MCU: R56.1; also elsewhere on the board
DO1_SINK: D6.2 (A), Q6.2 (C); also elsewhere on the board
DO2_SINK: D5.2 (A), Q5.2 (C); also elsewhere on the board
DO3_SINK: D1.2 (A), Q2.2 (C); also elsewhere on the board
GND: C4.2, C38.2, C39.2, C40.2, C41.2, C44.1, C45.2, C46.1, D10.3 (common), D12.3 (common), D19.2 (A2), D23.2 (A2), Q2.3 (E), Q5.3 (E), Q6.3 (E), R5.2, R55.2, R62.1, R76.1, R79.1, R82.1, R91.2, R94.2, U1.2 (GND), U1.5 (SHDN), U3.5 (GND), U6.2, U10.2, U11.2, U12.2, U12.3, U14.2, U14.3; also elsewhere on the board
unnamed: C44.2, R57.1, R58.1
unnamed: Q2.1 (B), R76.2, U11.3
unnamed: Q5.1 (B), R79.2, U6.3
unnamed: Q6.1 (B), R82.2, U10.3
unnamed: R74.2, U11.1
unnamed: R75.1, U11.4
unnamed: R77.2, U6.1
unnamed: R78.1, U6.4
unnamed: R80.2, U10.1
unnamed: R81.1, U10.4
unnamed: R90.2, R91.1, U12.1
unnamed: R93.2, R94.1, U14.1
unnamed: R55.1, U1.8 (S)
unnamed: R9.1, U3.2 (~RE), U3.3 (DE)

Notes on the sheet:
4. UART
3.1. LED 24V
6. SWITCH
1. RS485
3.2. LED 24V
2. CAN

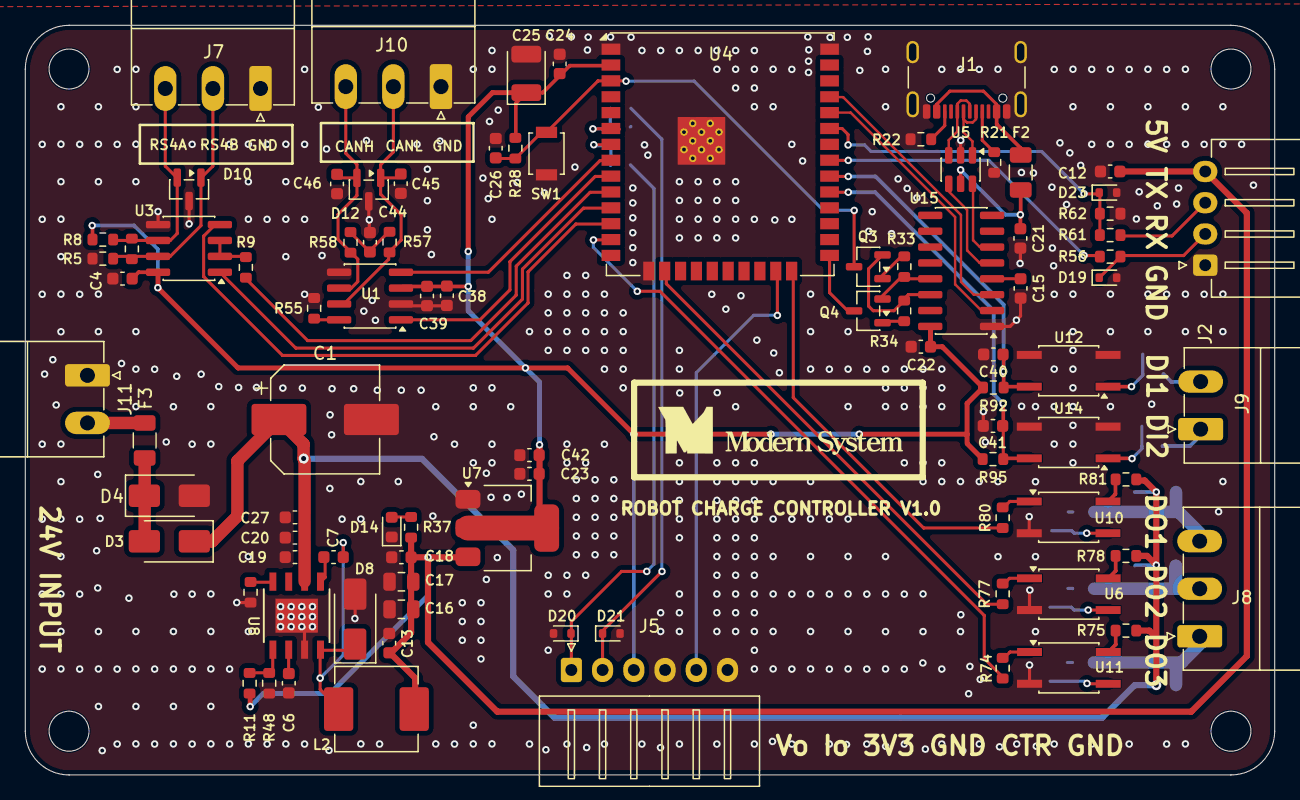
[picture p32: board control-board.kicad_pcb from above]

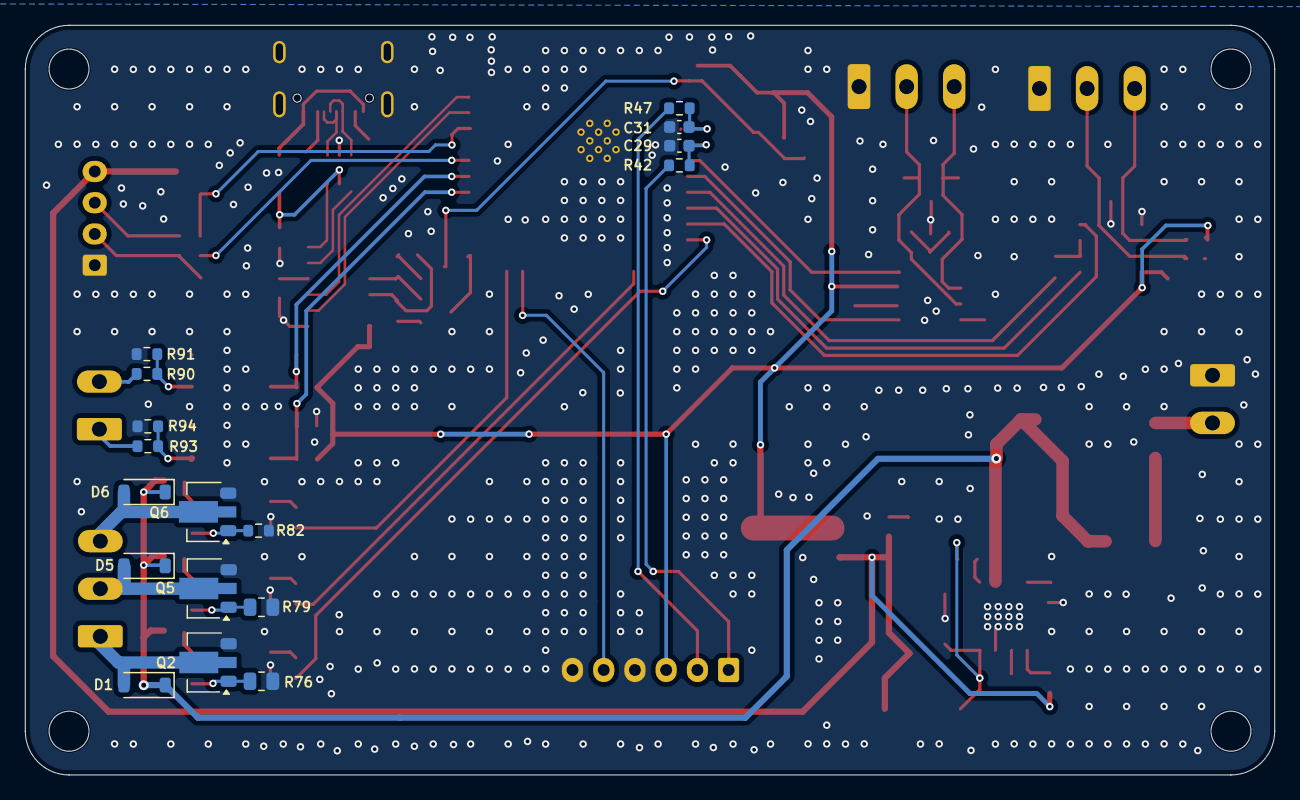
[picture p33: board control-board.kicad_pcb from below]

Board: 2 copper layers, 100.0 x 60.0 mm, 111 parts (17 on the bottom side), 71 nets.
