whoisLePhuc/robot_charge_controller/(commit log)

2026-08-11 Add KiCad ignore rules to .gitignore
    Ultraworked with [Sisyphus](https://github.com/code-yeongyu/oh-my-openagent)
2026-08-11 Add KiCad schematic sheets
    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
    [Auxiliary_Power_Supply.kicad_sch, Communication_Interfaces.kicad_sch, Current_Sensing.kicad_sch, Input_Protection.kicad_sch, MCU_Control.kicad_sch, Main_Relay_Control.kicad_sch, Output_Protection_And_Sensing.kicad_sch, robot-hv-charge-controller.kicad_sch]
2026-08-11 Add KiCad PCB layout and project config
    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
    [robot-hv-charge-controller.kicad_pcb]
2026-08-12 fix: ground capacitor C3 C2
    [Main_Relay_Control.kicad_sch]
2026-08-12 feat: update components link, footprint and package
    [Main_Relay_Control.kicad_sch, robot-hv-charge-controller.kicad_pcb]
2026-08-12 feat: update buy link, footprint
    [Main_Relay_Control.kicad_sch, Output_Protection_And_Sensing.kicad_sch]
2026-08-12 feat: update footprint power supply
    [Auxiliary_Power_Supply.kicad_sch, Communication_Interfaces.kicad_sch, Current_Sensing.kicad_sch, MCU_Control.kicad_sch, Main_Relay_Control.kicad_sch, Output_Protection_And_Sensing.kicad_sch, robot-hv-charge-controller.kicad_pcb, robot-hv-charge-controller.kicad_sch]
2026-08-13 feat: update schematic with new components for communication interfaces and export BOM list
    [Auxiliary_Power_Supply.kicad_sch, BOM.csv, Communication_Interfaces.kicad_sch, Current_Sensing.kicad_sch, MCU_Control.kicad_sch, Main_Relay_Control.kicad_sch, Output_Protection_And_Sensing.kicad_sch, robot-hv-charge-controller.kicad_pcb]
2026-08-13 Refactor code structure for improved readability and maintainability
    [Input_Protection.kicad_sch, Main_Relay_Control.kicad_sch, Output_Protection_And_Sensing.kicad_sch, robot-hv-charge-controller.kicad_sch]
2026-08-24 feat: Finished demo schematic and routing PCB
    [Auxiliary_Power_Supply.kicad_sch, BOM.csv, Communication_Interfaces.kicad_sch, Current_Sensing.kicad_sch, MCU_Control.kicad_sch, Main_Relay_Control.kicad_sch, Output_Protection_And_Sensing.kicad_sch, robot-hv-charge-controller.kicad_pcb]
2026-08-24 feat: add schematic pdf file
2026-08-24 feat: update symbols and footprint path
2026-08-24 refactor(hardware): restructure KiCad project for portability
    Move KiCad project files from Hardware/kicad/ to Hardware/ root so the
    project is self-contained and opens cleanly after a fresh clone. Replace
    absolute Windows 3D-model paths (D:/Working_space/...) in XT30, XT60 and
    LV14340 (SOIC8_DDA_TEX) footprints with ${KIPRJMOD}-relative paths, and
    point fp/sym-lib-table at ${KIPRJMOD} so libraries resolve on any machine.
    Drop the obsolete Current_Sensing sheet no longer referenced by the
    hierarchy. PCB 3D models are embedded (kicad-embed://), so no external
    files are required to render the board.
    [Auxiliary_Power_Supply.kicad_sch, Communication_Interfaces.kicad_sch, Current_Sensing.kicad_sch, MCU_Control.kicad_sch, Main_Relay_Control.kicad_sch, Output_Protection_And_Sensing.kicad_sch, robot-hv-charge-controller.kicad_pcb, robot-hv-charge-controller.kicad_sch]
2026-08-24 fix(hardware): resolve PCB 3D model paths via KIPRJMOD
    Replace the undefined variable in all 46 footprint 3D-model
    references inside the PCB with /libraries/3d-models/ so the
    3D viewer can resolve the STEP models from the project directory on any
    machine. Verified with kicad-cli: PCB parses (DRC), 3D render loads all
    models successfully, and no references remain.
    [robot-hv-charge-controller.kicad_pcb]
2026-08-25 fix(hardware): revise optocoupler control logic
    Update relay and communication optocoupler drive networks, then synchronize the related PCB routing and KiCad project metadata.
    [Communication_Interfaces.kicad_sch, Main_Relay_Control.kicad_sch, robot-hv-charge-controller.kicad_pcb]
2026-08-25 fix(hardware): reroute PCB for schematic updates
    Synchronize PCB routing and net assignments with the revised optocoupler control design, including related auxiliary power and USB signal wiring updates.
    [Auxiliary_Power_Supply.kicad_sch, MCU_Control.kicad_sch, robot-hv-charge-controller.kicad_pcb]
2026-08-25 refactor(hardware): move KiCad project into One_Board_Design/
    Relocate the single-board KiCad project (root schematic, five hierarchical sheets, PCB, project file, and library tables) into Hardware/One_Board_Design/ so the shared symbols, footprints, and 3D models stay in Hardware/libraries/.
    Update library tables and 3D model references to use \/../libraries/... so the moved project resolves the shared library location correctly. Replace SparkFun symbol references with the equivalent KiCad standard symbols. Add One_Board_Design README documenting the shared-library layout.
    Ultraworked with [Sisyphus](https://github.com/code-yeongyu/oh-my-openagent)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
    [Auxiliary_Power_Supply.kicad_sch, Communication_Interfaces.kicad_sch, MCU_Control.kicad_sch, Main_Relay_Control.kicad_sch, Output_Protection_And_Sensing.kicad_sch, robot-hv-charge-controller.kicad_pcb, robot-hv-charge-controller.kicad_sch]
2026-08-25 fix(hardware): correct 3D model paths in shared footprints
    Point AMASS XT30/XT60 and SOIC8_DDA_TEX footprint 3D models at \/../libraries/3d-models/ so they resolve correctly now that the KiCad project lives in One_Board_Design/.
    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
2026-08-25 chore: remove in-development hardware designs from main
    main now holds only the stable project skeleton (README, LICENSE, .gitignore, Docs). Hardware designs live on dedicated branches: design/one-board and design/split-board. Shared libraries will be maintained on develop.
    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
    [Auxiliary_Power_Supply.kicad_sch, Communication_Interfaces.kicad_sch, MCU_Control.kicad_sch, Main_Relay_Control.kicad_sch, Output_Protection_And_Sensing.kicad_sch, robot-hv-charge-controller.kicad_pcb, robot-hv-charge-controller.kicad_sch]
2026-08-25 chore: keep shared libraries on develop, remove board designs
    develop holds the project skeleton plus Hardware/libraries/ as the single source of truth for shared symbols, footprints, and 3D models. Board designs (schematics, PCB, project files) live on design/one-board and design/split-board, which merge develop to receive library updates.
    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
    [Auxiliary_Power_Supply.kicad_sch, Communication_Interfaces.kicad_sch, MCU_Control.kicad_sch, Main_Relay_Control.kicad_sch, Output_Protection_And_Sensing.kicad_sch, robot-hv-charge-controller.kicad_pcb, robot-hv-charge-controller.kicad_sch]
2026-08-25 docs: add development workflow guide
    Document the GitFlow-style branch model: main holds stable release state, develop integrates changes and hosts shared libraries, and each board design lives on its own design/* branch that merges develop for library updates.
    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
2026-08-25 chore: restructure repository to match README layout
    Create the folder structure described in README.md, each folder with a README.md describing its purpose: docs/ (01-requirements..06-verification, decisions), hardware/ (kicad, libraries, templates), firmware/ (include, src, lib, test), simulation/, components/, manufacturing/, test/, tools/. Rename Docs/ to docs/ and remove the obsolete Schematic.pdf.
    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
2026-08-25 chore: remove hardware/kicad folder, keep board designs in hardware/
    The kicad folder is unnecessary: board designs live under hardware/One_Board_Design/ and hardware/Split_Board_Design/ after their branches are merged.
    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
2026-08-25 chore: restructure repository to match main layout
    Sync design/one-board with main structure: rename Docs/ to docs/, drop obsolete Schematic.pdf, rename Hardware/ to hardware/ (keeping One_Board_Design and shared libraries), and add README.md to each folder.
    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
    [Auxiliary_Power_Supply.kicad_sch, Communication_Interfaces.kicad_sch, MCU_Control.kicad_sch, Main_Relay_Control.kicad_sch, Output_Protection_And_Sensing.kicad_sch, robot-hv-charge-controller.kicad_pcb, robot-hv-charge-controller.kicad_sch]
2026-08-25 chore(repo): establish coexisting hardware baseline
    [BOM.xlsx, Full_BOM.xlsx]
2026-08-26 upđate: Some minor change in PCB
    [robot-hv-charge-controller.kicad_pcb]
2026-08-26 feat(library): update LV14340DDAR EPAD pin to power input
2026-08-27 feat(hardware): complete control board schematic and PCB layout
    Add the completed hierarchical schematic design for the split control board, covering auxiliary power, relay control, MCU, communication interfaces, output protection, and sensing.
    Add the finished PCB placement and routing together with the KiCad project configuration and project-local symbol and footprint library tables.
    Validation: ERC 0 errors; DRC 0 errors.
    [Auxiliary_Power_Supply.kicad_sch, Communication_Interfaces.kicad_sch, MCU_Control.kicad_sch, Main_Relay_Control.kicad_sch, Output_Protection_And_Sensing.kicad_sch, Output_Sensing.kicad_sch, control-board.kicad_pcb, control-board.kicad_sch]
2026-08-27 feat(layout): finish demo layout and schematic for relay board
    [Relay_control.kicad_sch, Sensing.kicad_sch, relay-board.kicad_pcb, relay-board.kicad_sch]
2026-08-29 feat(BOM): Update BOM list for two boards
    [BOM.xlsx, Bill of Materials-Control_Board_V1.0.xlsx, Bill of Materials-Relay_Board_V1.0.xlsx, Bill of Materials-Robot_Recharge_V1.0.xlsx, Full_BOM.xlsx]
2026-08-29 feat(library): Update resistor shunt symbol and footprint
2026-08-29 feat(layout): Finish demo layout of relay board
    [Output_Sensing.kicad_sch, Relay_control.kicad_sch, Sensing.kicad_sch, relay-board.kicad_pcb, relay-board.kicad_sch]
2026-08-29 feat(docs): Add consolidate folder contrain relay board information
2026-08-29 feat(layout): Finished demo schematic for control board
    [Auxiliary_Power_Supply.kicad_sch, Communication_Interfaces.kicad_sch, MCU_Control.kicad_sch, Output_Protection_And_Sensing.kicad_sch, Output_Sensing.kicad_sch, control-board.kicad_pcb, control-board.kicad_sch]
2026-08-29 feat(docs): Add control board consolidated documents
2026-08-31 feat(layout): Update layout
    [Auxiliary_Power_Supply.kicad_sch, MCU_Control.kicad_sch, Output_Sensing.kicad_sch, control-board.kicad_pcb, control-board.kicad_sch, relay-board.kicad_pcb]
2026-08-31 feat(schematic): update INA240A2PW to ÍNA240A2D
    [Auxiliary_Power_Supply.kicad_sch, MCU_Control.kicad_sch, relay-board.kicad_pcb]
2026-09-03 Some minor updates
    [MCU_Control.kicad_sch, Output_Sensing.kicad_sch, control-board.kicad_pcb]
2026-09-04 feat(footprint): edit R_Shunt_FOJAN_2512L_4Terminal_Kelvin_C
2026-09-04 feat(layout): update control board layout
    [Auxiliary_Power_Supply.kicad_sch, Communication_Interfaces.kicad_sch, MCU_Control.kicad_sch, control-board.kicad_pcb, control-board.kicad_sch]
2026-09-04 feat(layout): update relay board layout
    [Output_Sensing.kicad_sch, Relay_control.kicad_sch, relay-board.kicad_pcb, relay-board.kicad_sch]
2026-09-05 layout: update layout
    [Auxiliary_Power_Supply.kicad_sch, Communication_Interfaces.kicad_sch, MCU_Control.kicad_sch, control-board.kicad_pcb, control-board.kicad_sch, relay-board.kicad_pcb, relay-board.kicad_sch]
